Maxim-1301/Projektarbeit_Joystick/KiCAD_Schaltplan/KommModul_Joystick/report.txt

Plot in "C:\Users\jonat\OneDrive\Documents\GitHub\Projektarbeit_Joystick\KiCAD_Schaltplan\KommModul_Joystick\Gerber_Files\KommModul_Joystick-F_Cu.gbr" geschrieben.
Plot in "C:\Users\jonat\OneDrive\Documents\GitHub\Projektarbeit_Joystick\KiCAD_Schaltplan\KommModul_Joystick\Gerber_Files\KommModul_Joystick-B_Cu.gbr" geschrieben.
Plot in "C:\Users\jonat\OneDrive\Documents\GitHub\Projektarbeit_Joystick\KiCAD_Schaltplan\KommModul_Joystick\Gerber_Files\KommModul_Joystick-F_Paste.gbr" geschrieben.
Plot in "C:\Users\jonat\OneDrive\Documents\GitHub\Projektarbeit_Joystick\KiCAD_Schaltplan\KommModul_Joystick\Gerber_Files\KommModul_Joystick-B_Paste.gbr" geschrieben.
Plot in "C:\Users\jonat\OneDrive\Documents\GitHub\Projektarbeit_Joystick\KiCAD_Schaltplan\KommModul_Joystick\Gerber_Files\KommModul_Joystick-F_Silkscreen.gbr" geschrieben.
Plot in "C:\Users\jonat\OneDrive\Documents\GitHub\Projektarbeit_Joystick\KiCAD_Schaltplan\KommModul_Joystick\Gerber_Files\KommModul_Joystick-B_Silkscreen.gbr" geschrieben.
Plot in "C:\Users\jonat\OneDrive\Documents\GitHub\Projektarbeit_Joystick\KiCAD_Schaltplan\KommModul_Joystick\Gerber_Files\KommModul_Joystick-F_Mask.gbr" geschrieben.
Plot in "C:\Users\jonat\OneDrive\Documents\GitHub\Projektarbeit_Joystick\KiCAD_Schaltplan\KommModul_Joystick\Gerber_Files\KommModul_Joystick-B_Mask.gbr" geschrieben.
Plot in "C:\Users\jonat\OneDrive\Documents\GitHub\Projektarbeit_Joystick\KiCAD_Schaltplan\KommModul_Joystick\Gerber_Files\KommModul_Joystick-Edge_Cuts.gbr" geschrieben.
Gerber-Jobdatei "C:\Users\jonat\OneDrive\Documents\GitHub\Projektarbeit_Joystick\KiCAD_Schaltplan\KommModul_Joystick\Gerber_Files\KommModul_Joystick-job.gbrjob" wurde erstellt.
Hinweis: Fertig.
