Maxim-1301/Projektarbeit_Joystick/Auswertung/Hebel_Links_Vor.log.txt

=~=~=~=~=~=~=~=~=~=~=~= PuTTY log 2026.06.17 11:59:13 =~=~=~=~=~=~=~=~=~=~=~=
218 503697 ms FRAME: C5 25 01 00 61  OK
503701 ms FRAME: C5 2F 00 00 6A  OK
503727 ms FRAME: C5 25 01 00 61  OK
503731 ms FRAME: C5 30 00 00 75  OK
503757 ms FRAME: C5 25 01 00 61  OK
503761 ms FRAME: C5 31 0B 53 2C  OK
503787 ms FRAME: C5 25 01 00 61  OK
503791 ms FRAME: C5 32 01 57 21  OK
503817 ms FRAME: C5 25 01 00 61  OK
503821 ms FRAME: C5 3A 00 00 7F  OK
503847 ms FRAME: C5 25 01 00 61  OK
503851 ms FRAME: C5 3B 01 6C 13  OK
503877 ms FRAME: C5 25 01 00 61  OK
503881 ms FRAME: C5 3C 00 00 79  OK
503907 ms FRAME: C5 25 01 00 61  OK
503911 ms FRAME: C5 3D 02 71 0B  OK
503938 ms FRAME: C5 25 01 00 61  OK
503941 ms FRAME: C5 3E 00 16 6D  OK
503968 ms FRAME: C5 25 01 00 61  OK
503971 ms FRAME: C5 3F 0B 6B 1A  OK
503998 ms FRAME: C5 25 01 00 61  OK
504001 ms FRAME: C5 4F 69 7F 1C  OK
504028 ms FRAME: C5 25 01 00 61  OK
504031 ms FRAME: C5 50 02 57 40  OK
504058 ms FRAME: C5 25 01 00 61  OK
504061 ms FRAME: C5 51 00 00 14  OK
504088 ms FRAME: C5 25 01 00 61  OK
504091 ms FRAME: C5 52 02 4B 5E  OK
504118 ms FRAME: C5 25 01 00 61  OK
504121 ms FRAME: C5 1D 04 0B 57  OK
504148 ms FRAME: C5 25 01 00 61  OK
504151 ms FRAME: C5 1E 00 63 38  OK
504178 ms FRAME: C5 25 01 00 61  OK
504181 ms FRAME: C5 1F 00 00 5A  OK
504208 ms FRAME: C5 25 01 00 61  OK
504211 ms FRAME: C5 20 00 00 65  OK
504238 ms FRAME: C5 25 01 00 61  OK
504241 ms FRAME: C5 21 00 00 64  OK
504268 ms FRAME: C5 25 01 00 61  OK
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
532914 ms FRAME: C5 25 01 00 61  OK
532917 ms FRAME: C5 32 01 58 2E  OK
532944 ms FRAME: C5 25 01 00 61  OK
532947 ms FRAME: C5 3A 00 00 7F  OK
532974 ms FRAME: C5 25 01 00 61  OK
532977 ms FRAME: C5 3B 01 42 3D  OK
533004 ms FRAME: C5 25 01 00 61  OK
533007 ms FRAME: C5 3C 00 00 79  OK
5
