Maxim-1301/Projektarbeit_Joystick/Auswertung/Hebel_Links_Zurueck.log.txt

=~=~=~=~=~=~=~=~=~=~=~= PuTTY log 2026.06.17 12:02:02 =~=~=~=~=~=~=~=~=~=~=~=
535256 ms FRAME: C5 25 01 00 61  OK
535260 ms FRAME: C5 20 00 00 65  OK
535286 ms FRAME: C5 25 01 00 61  OK
535290 ms FRAME: C5 21 00 00 64  OK
535316 ms FRAME: C5 25 01 00 61  OK
535320 ms FRAME: C5 22 00 00 67  OK
535346 ms FRAME: C5 25 01 00 61  OK
535350 ms FRAME: C5 23 02 77 13  OK
535376 ms FRAME: C5 25 01 00 61  OK
535380 ms FRAME: C5 2672778 ms FRAME: C5 25 01 00 61  OK
672781 ms FRAME: C5 24 02 5A 39  OK
672808 ms FRAME: C5 25 01 00 61  OK
672811 ms FRAME: C5 25 02 5C 3E  OK
672838 ms FRAME: C5 25 01 00 61  OK
672841 ms FRAME: C5 26 00 02 61  OK
672868 ms FRAME: C5 25 01 00 61  OK
672871 ms FRAME: C5 27 00 0D 6F  OK
672898 ms FRAME: C5 25 01 00 61  OK
672901 ms FRAME: C5 28 63 26 28  OK
672928 ms FRAME: C5 25 01 00 61  OK
672931 ms FRAME: C5 29 1C 04 74  OK
672958 ms FRAME: C5 25 01 00 61  OK
672961 ms FRAME: C5 2A 2B 5E 1A  OK
672988 ms FRAME: C5 25 01 00 61  OK
672991 ms FRAME: C5 2B 0E 0C 6C  OK
673018 ms FRAME: C5 25 01 00 61  OK
673021 ms FRAME: C5 2C 00 00 69  OK
673048 ms FRAME: C5 25 01 00 61  OK
673052 ms FRAME: C5 2D 00 00 68  OK
673078 ms FRAME: C5 25 01 00 61  OK
673082 ms FRAME: C5 2E 00 00 6B  OK
673108 ms FRAME: C5 25 01 00 61  OK
673112 ms FRAME: C5 2F 00 00 6A  OK
673138 ms FRAME: C5 25 01 00 61  OK
673142 ms FRAME: C5 30 00 00 75  OK
673168 ms FRAME: C5 25 01 00 61  OK
673172 ms FRAME: C5 31 0B 53 2C  OK
673198 ms FRAME: C5 25 01 00 61  OK
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
727061 ms FRAME: C5 25 01 00 61  OK
727064 ms FRAME: C5 3B 01 24 5B  OK
727091 ms FRAME: C5 25 01 00 61  OK
727094 ms FRAME: C5 3C 00 00 79  OK
727121 ms FRAME: C5 25 01 00 61  OK
727124 ms FRAME: C5 3D 02 6E 14  OK
727151 ms FRAME: C5 25 01 00 61  OK
727154 ms FRAME: C5 3E 00 13 68  OK
7
