Maxim-1301/Projektarbeit_Joystick/Dokumentation/Projektarbeit_Orange_Blue_Joystick_ma871cas_jo871sto.docx

# Projektarbeit Orange Blue-Motorsteuerung mit Joystick

Student: Castor Maxim

Matrikel Nr.: 310314

Studiengang: EIB 6

Student: Jonathan Stoll

Matrikel Nr.: 310269

Studiengang: EIB6

Hochschulbetreuer/in: Prof. Dr. Boris Boeck

Datum der Abgabe: 28.08.2026

# Abbildungsverzeichnis

# Tabellenverzeichnis

# 1 Einleitung

Das Orange-Blue Projekt ist ein Hochschulprojekt, in dem Studierende, Professoren und Laboringenieure gemeinsam an der Weiterentwicklung eines Tragflügelbootes arbeiten. Ziel des Projekts ist es, verschiedene technische Komponenten des Bootes weiterzuentwickeln und für den praktischen Einsatz zuverlässig nutzbar zu machen.

Ein wichtiger Bestandteil des Systems ist die Steuerung der Antriebsmotoren. Hierfür wird ein Kommunikationsmodul benötigt, das die Eingaben des Fahrers erfasst und in entsprechende Steuerbefehle für die Motoren umsetzt. Das ursprünglich verwendete Bedienmodul des Motorherstellers war für den vorgesehenen Einsatz zuverlässig nutzbar. Mit diesem Steuerungsmodul jedoch werden beide Motoren über separate Hebel angesteuert, was die Nutzung weniger Intuitiv machte.

Aus diesem Grund wurde bereits in einer früheren Bachelorarbeit ein eigenes Kommunikationsmodul für das Tragflügelboot entwickelt, um die Steuerung des Tragflügelbootes einfacher und intuitiver zu gestalten. Über einen Joystick sollte der Fahrer die Fahrtrichtung und die Leistung der Antriebsmotoren direkt vorgeben können. Dadurch sollte eine übersichtliche und einfach zu bedienende Alternative zum ursprünglichen Bedienmodul des Herstellers entstehen.

Bei der Inbetriebnahme des Moduls zeigte sich jedoch, dass das vorhandene Kommunikationsmodul nicht zuverlässig funktionierte und sowohl die Hardware als auch die Software nicht mehr dem aktuellen technischen Stand entsprachen. Daher bestand die Aufgabe darin, das bestehende System zunächst zu analysieren und anschließend gezielt zu überarbeiten.

Ziel der Projektarbeit war es, ein funktionsfähiges und technisch aktualisiertes Kommunikationsmodul aufzubauen. Der Schwerpunkt lag dabei auf der Entwicklung einer neuen Platine, der Überarbeitung der zugehörigen Software und der zuverlässigen Kommunikation mit den Steuerungsplatinen der beiden Motoren. Das grundlegende Funktionsprinzip des bisherigen Systems wurde dabei übernommen und an die neuen Anforderungen angepasst.

# 2 Analyse und Vorgehen

## 2.1 Ausgangssystem und Funktionsweise

Als Grundlage der Projektarbeit diente das Kommunikationsmodul, das im Rahmen einer früheren Bachelorarbeit für das Tragflügelboot entwickelt wurde. Ziel dieses Moduls war es, die Bedienung des Bootes gegenüber dem ursprünglichen Steuergerät des Motorherstellers zu vereinfachen. Der Fahrer sollte das Boot über einen Joystick steuern können, dessen Auslenkung in entsprechende Fahr- und Leistungsbefehle für die Antriebsmotoren umgesetzt wird. Zusätzlich sollten wichtige Betriebs- und Statusinformationen der Motoren auf einem Display dargestellt werden.

Die zentrale Verarbeitung des alten Moduls übernimmt ein ATmega1284P-Mikrocontroller. Dieser wertet die drei Achsen des Joysticks sowie dessen Taster aus und erzeugt daraus die Steuerbefehle für die Motoren. Für die Kommunikation mit den Motorsteuerungen sind zwei getrennte RS485-Schnittstellen vorgesehen. Die dafür benötigten UART-Signale des Mikrocontrollers werden über MAX485-Transceiver auf den RS485-Bus umgesetzt. Der Anschluss der beiden Motoren erfolgt über jeweils eine eigene Verbindung.

Das Kommunikationsmodul arbeitet gegenüber den Motorsteuerungen als Master. Es sendet Steuerbefehle an die Motoren und empfängt anschließend deren Antworten. Die Kommunikation erfolgt zyklisch und basiert auf dem vom Motorhersteller vorgegebenen Protokoll. Neben den eigentlichen Fahrbefehlen können dadurch auch Betriebsdaten der Motoren empfangen und ausgewertet werden.

Die Eingaben des Joysticks werden über integrierte Hallsensoren erfasst. Je nach Auslenkung der einzelnen Achsen verändert sich die ausgegebene analoge Spannung. Diese Spannungswerte werden vom Mikrocontroller über seine ADC-Eingänge eingelesen und anschließend in Fahrtrichtung und Leistungsanforderung für die Motoren umgerechnet. In der Mittelstellung liegt die Ausgangsspannung ungefähr bei 2,3 V, während sie sich je nach Auslenkung in Richtung 0 V beziehungsweise bis etwa 4,6 V verändert. Die vom Motor zurückgesendeten Statusinformationen werden anschließend verarbeitet und auf einem 4×20-Zeichen-Display ausgegeben. Das Display wird über eine I²C-Schnittstelle und einen Portexpander angesteuert.

Das ursprüngliche Konzept war außerdem so ausgelegt, dass das System auf vier Motoren erweitert werden konnte. Dafür war eine zweite Platine vorgesehen, die über eine SPI-Verbindung mit der Hauptplatine kommuniziert. Für die in dieser Projektarbeit betrachtete Überarbeitung stand jedoch zunächst die zuverlässige Ansteuerung der beiden vorhandenen Motoren im Vordergrund.

Da Aufbau und Funktionsweise des ursprünglichen Kommunikationsmoduls bereits ausführlich in der Bachelorarbeit dokumentiert sind, werden sie an dieser Stelle nur in dem für die weitere Bearbeitung notwendigen Umfang betrachtet. Der Schwerpunkt der folgenden Kapitel liegt auf der Analyse der vorhandenen Lösung sowie der daraus abgeleiteten Überarbeitung von Hard- und Software

## 2.2 Analyse der Hardware und Software

### 2.2.1 Hardware

Für die Analyse der vorhandenen Hardware wurden die Bachelorarbeit, die bereits gefertigte Platine sowie das zugehörige KiCad-Projekt herangezogen. Ziel war es, den Aufbau des bestehenden Kommunikationsmoduls nachzuvollziehen und mögliche Ursachen für die eingeschränkte Funktion zu finden.

Dazu wurden die einzelnen Komponenten der Schaltung schrittweise untersucht. Betrachtet wurden unter anderem die Spannungsversorgung, die Beschaltung des Mikrocontrollers, die RS485-Schnittstellen, die Joystickanbindung sowie die Displaysteuerung. Zusätzlich wurde die gefertigte Platine mit einem Multimeter auf Durchgang geprüft. Dadurch sollten mögliche Kurzschlüsse, unterbrochene Verbindungen oder Fehler im Leiterplattenrouting erkannt werden. Der grundsätzliche Aufbau entsprach dabei dem in der Bachelorarbeit beschriebenen Konzept.

Bei der Untersuchung konnten keine eindeutigen hardwareseitigen Fehler festgestellt werden, die das fehlerhafte Verhalten des Kommunikationsmoduls erklären konnten. Einzelne Dimensionierungen waren jedoch nicht vollständig nachvollziehbar. Dazu gehörte beispielsweise die Verwendung eines vergleichsweise großen Pufferkondensators von 330 µF. Da sich daraus jedoch kein direkter Funktionsfehler ableiten ließ, wurde die bestehende Hardware grundsätzlich als funktionsfähig bewertet.

Aus diesem Grund wurde entschieden, den grundlegenden Aufbau des vorhandenen Kommunikationsmoduls als Basis für die neue Hardware zu verwenden. Das betraf vor allem die Aufteilung in Mikrocontroller, Joystickanbindung, zwei RS485-Schnittstellen und Displayansteuerung. Für die neue Umsetzung waren dennoch mehrere Anpassungen notwendig, insbesondere durch den Wechsel auf einen STM32-Mikrocontroller und die damit verbundenen elektrischen Anforderungen. Diese Änderungen werden im Kapitel zur Hardwareentwicklung näher beschrieben.

### 2.2.2 Software

Für die Analyse der vorhandenen Software wurden die einzelnen C-Dateien sowie die zugehörigen Header-Dateien des Projekts untersucht. Ziel war es zunächst, den Aufbau des Programms und das Zusammenspiel der einzelnen Softwaremodule nachzuvollziehen. Dabei wurden vor allem die Verarbeitung der Joystickwerte, die Kommunikation mit den Motorsteuerungen sowie die Ansteuerung der verwendeten Peripherie betrachtet. Die ursprüngliche Software war bereits in mehrere Teilprogramme gegliedert, unter anderem für UART, ADC, I²C und die Verarbeitung der Motordaten.

Bei der Durchsicht des Programmcodes fielen mehrere kleinere Stellen auf, die nicht eindeutig oder nicht sauber umgesetzt waren. Zwei Punkte wurden dabei als besonders relevant für die eingeschränkte Funktion des Kommunikationsmoduls eingestuft.

Der erste Punkt betraf die UART-Kommunikation mit den Motorsteuerungen. Die vorhandene Implementierung entsprach teilweise nicht dem im Datenblatt des ATmega beschriebenen Ablauf für das Senden und Empfangen von Daten. Insbesondere die Abfrage und Verarbeitung empfangener Daten war nicht eindeutig umgesetzt. Dadurch konnte nicht ausgeschlossen werden, dass einzelne Bytes fehlerhaft oder zum falschen Zeitpunkt verarbeitet wurden. Dies stellte eine mögliche Ursache für eine unzuverlässige Kommunikation mit den Motorsteuerungen dar.

Der zweite und deutlich schwerwiegendere Punkt wurde bei der Verarbeitung der Joystickwerte festgestellt. Der aus der Joystickauslenkung berechnete Leistungswert wurde in der vorhandenen Software lediglich auf einen Maximalwert von 0x07 begrenzt. Dieser Wert wird anschließend innerhalb des Beschleunigungskommandos an die Motorsteuerung übertragen. Warum der Wertebereich auf 0x00 bis 0x07 festgelegt worden war, konnte aus der vorhandenen Dokumentation und dem Programmcode nicht eindeutig nachvollzogen werden. Möglicherweise wurde der Wert zu Testzwecken auf den geringen Leistungswert maximiert, jedoch wurde diesbezüglich nichts in der Bachelorarbeit dokumentiert.

Diese Auffälligkeit passte zu den Erfahrungen aus früheren Tests des bestehenden Kommunikationsmoduls. Dabei konnten die Motoren grundsätzlich angesteuert werden, erreichten jedoch nur eine sehr geringe Drehzahl. Es bestand daher der Verdacht, dass der in der Software verwendete Wertebereich nicht dem tatsächlich von der Motorsteuerung erwarteten Leistungsbereich entsprach.

Um diesen Verdacht zu überprüfen und den tatsächlichen Aufbau der Kommunikation genauer zu untersuchen, wurde anschließend die Kommunikation des originalen Bedienmoduls des Herstellers mitgeschnitten und ausgewertet. Dadurch konnte der tatsächlich verwendete Wertebereich der Motoransteuerung bestimmt und die zuvor festgestellte Auffälligkeit in der Software überprüft werden.

## 2.3 Untersuchung der Motorkommunikation

Um den tatsächlichen Aufbau der Kommunikation zwischen dem originalen Bedienmodul des Herstellers und den Motorsteuerungen zu überprüfen, wurde die RS485-Kommunikation während des Betriebs mitgeschnitten. Dazu wurde ein separates Testmodul verwendet, das über einen RS485-Transceiver parallel an die Kommunikationsleitung zwischen Bedienmodul und Motor angeschlossen wurde. Dadurch konnten die übertragenen Daten mitgelesen werden, ohne die bestehende Kommunikation zu beeinflussen.

Das originale Bedienmodul kann sowohl über die kabelgebundene Verbindung als auch über Funk mit den Motoren kommunizieren. Für die Untersuchung wurde gezielt die kabelgebundene Kommunikation ausgewertet, da das neue Kommunikationsmodul mit dem Joystick ebenfalls über ein RS485 Kabel mit den Motoren verbunden werden sollte. Während der Messungen wurden die Fahrhebel in verschiedene Positionen bewegt und die dabei übertragenen Daten aufgezeichnet. Ziel war es, den tatsächlichen Aufbau der Steuerbefehle und insbesondere die Übertragung von Fahrtrichtung und Leistungswert zu bestimmen.

Die Kommunikation zwischen Bedienmodul und Motorsteuerung erfolgt in Form von fünf Byte langen Datenframes. Jedes Frame beginnt mit dem Adressbyte 0xC5. Darauf folgt ein Kommando- beziehungsweise Statusbyte, das festlegt, welche Information übertragen wird. Die beiden nachfolgenden Datenbytes enthalten die eigentlichen Nutzdaten. Das letzte Byte bildet die Checksumme zur Überprüfung des Frames. Dieser grundsätzliche Aufbau entspricht auch der Beschreibung in der bestehenden Bachelorarbeit.

Für die Untersuchung der Motoransteuerung war insbesondere das Beschleunigungskommando 0x25 relevant. In dem zugehörigen Datenframe enthält das dritte Byte die Information über die Fahrtrichtung, während das vierte Byte den angeforderten Leistungswert überträgt. Bei Vorwärtsfahrt wird im dritten Byte der Wert 0x01, bei Rückwärtsfahrt der Wert 0x00 gesendet. Der Wert im vierten Byte verändert sich abhängig von der Stellung des Fahrhebels und gibt damit die gewünschte Motorleistung vor.

Da RS485 in diesem System als Halbduplex-Verbindung betrieben wird, kann zu einem Zeitpunkt jeweils nur ein Teilnehmer senden. Nach dem Senden eines Kommando-Frames schaltet das Bedienmodul daher vom Sende- in den Empfangsbetrieb um. Die Motorsteuerung antwortet anschließend mit einem eigenen fünf Byte langen Frame. Danach wird wieder in den Sendebetrieb gewechselt und das nächste Kommando übertragen. Im aufgezeichneten Verlauf ist dieses Wechselspiel deutlich zu erkennen.

Der Aufbau eines aufgezeichneten Frames kann damit vereinfacht wie folgt dargestellt werden:

Byte | Bedeutung
1 | Adresse 0xC5
2 | Kommando
3 | Fahrtrichtung
4 | Leistungswert
5 | Checksumme

Tabelle 1, Aufbau Datenframes

Die Abbildung1 zeigt einen Ausschnitt des mit PuTTY aufgezeichneten Kommunikationsverlaufs während einer zunehmenden Vorwärtsauslenkung des Fahrhebels.

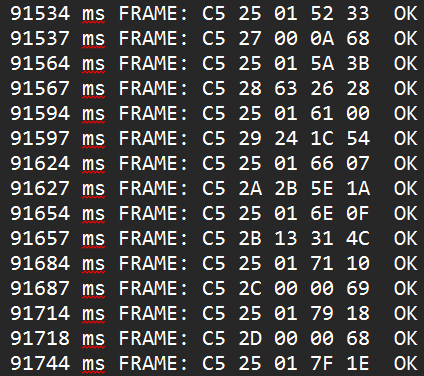
[picture p1: figure]

Abbildung 1, Mitschnitt Kommunikation

Die vom Bedienmodul gesendeten Beschleunigungsframes beginnen jeweils mit C5 25. Das erste Byte 0xC5 ist die Adresse der Motorsteuerung, während das zweite Byte 0x25 das Beschleunigungskommando kennzeichnet. Im dritten Byte wird die Fahrtrichtung übertragen. Im dargestellten Ausschnitt bleibt dieser Wert durchgehend auf 0x01, was der Vorwärtsfahrt entspricht. Das vierte Byte enthält den Leistungswert und verändert sich mit der Stellung des Fahrhebels.

Im Log ist zu erkennen, dass dieser Leistungswert mit zunehmender Auslenkung schrittweise ansteigt. Er verändert sich im dargestellten Abschnitt beispielsweise von 0x52 über 0x5A, 0x61, 0x66, 0x6E, 0x71 und 0x77 bis zum Maximalwert 0x7F.

Das letzte Frame des Ausschnitts C5 25 01 7F 1E entspricht damit einer vollständigen Vorwärtsauslenkung des Fahrhebels. Der Wert 0x7F im vierten Byte stellt die maximale Leistungsanforderung dar. In Neutralstellung wurde dagegen der Leistungswert 0x00 übertragen.

Zwischen den Beschleunigungsframes sind die Antworten der Motorsteuerung zu erkennen. Nach dem Senden eines 0x25-Frames wird die RS485-Schnittstelle vom Sende- in den Empfangsbetrieb umgeschaltet. Die Motorsteuerung antwortet daraufhin mit einem eigenen Frame, bevor das Bedienmodul wieder das nächste Beschleunigungskommando sendet. Im dargestellten Ausschnitt sind dabei verschiedene Statusantworten mit Kennungen wie 0x27, 0x28, 0x29 oder 0x2D zu erkennen. Die Bedeutung dieser Antwortkennungen ist ebenfalls in der Bachelorarbeit dokumentiert. In dieser Tabelle sind jedoch nicht alle Kommandos festgehalten. Im Laufe der Projektarbeit haben wir bei dem Hersteller der Motoren ePropulsion eine vollständige Tabelle dieser Kommandos angefragt aber leider nie eine Antwort erhalten.

Durch die Messung konnte, der zuvor bei der Softwareanalyse vermutete Fehler eindeutig bestätigt werden. In der vorhandenen Software des Kommunikationsmoduls wurde der aus der Joystickauslenkung berechnete Leistungswert lediglich auf einen Maximalwert von 0x07 begrenzt. Das originale Bedienmodul verwendet dagegen einen Wertebereich bis 0x7F.

Damit erklärt sich auch das Verhalten bei früheren Tests des bestehenden Kommunikationsmoduls. Die Motoren reagierten zwar auf die übertragenen Steuerbefehle, erreichten jedoch nur eine sehr geringe Drehzahl. Ursache dafür war, dass mit dem Maximalwert 0x07 nur ein kleiner Teil des tatsächlich vorgesehenen Leistungsbereichs genutzt wurde.

Die Auswertung des aufgezeichneten Kommunikationsverlaufs bestätigte somit sowohl den Aufbau des Beschleunigungskommandos als auch den korrekten Wertebereich der Motoransteuerung. Diese Ergebnisse wurden anschließend als Grundlage für die Überarbeitung der Software verwendet.

## 2.4 Schlussfolgerung für anstehende Überarbeitung

Die Analyse des bestehenden Kommunikationsmoduls zeigte, dass der grundlegende Aufbau des Systems weiterhin als geeignete Grundlage für eine Überarbeitung verwendet werden konnte. Bei der Untersuchung der Hardware konnten keine eindeutigen Fehler festgestellt werden, die die eingeschränkte Funktion des Moduls erklärten. Aus diesem Grund wurde das bestehende Hardwarekonzept grundsätzlich beibehalten und als Ausgangspunkt für die neue Platine verwendet.

Deutlich größere Probleme zeigten sich bei der vorhandenen Software. Neben einer nicht sauber umgesetzten UART-Kommunikation wurde insbesondere die fehlerhafte Skalierung des an die Motorsteuerung übertragenen Leistungswertes festgestellt. Durch das Mitschneiden der Kommunikation des originalen Bedienmoduls konnte verifiziert werden, dass der maximale Leistungswert 0x7F beträgt und nicht, wie in der bestehenden Software umgesetzt, 0x07. Damit konnte eine wesentliche Ursache für die sehr geringe Motordrehzahl bei früheren Tests des bestehenden Moduls identifiziert werden.

Aus den Ergebnissen der Analyse ergaben sich damit zwei zentrale Aufgaben für die weitere Bearbeitung. Zum einen musste die Hardware an einen aktuellen Mikrocontroller und dessen elektrische Anforderungen angepasst werden. Zum anderen war eine Überarbeitung der Software notwendig, insbesondere im Bereich der Motoransteuerung und der UART-/RS485-Kommunikation.

Die folgenden Kapitel beschreiben daher getrennt die Überarbeitung der Hardware und die Entwicklung der neuen Software. Dabei wird erläutert, welche Bestandteile des bestehenden Systems übernommen wurden, welche Änderungen notwendig waren und wie die zuvor identifizierten Probleme in der neuen Umsetzung berücksichtigt wurden.

# 3 Hardware

## 3.1 Hardwareübersicht

Die Hardware des überarbeiteten Kommunikationsmoduls wurde in mehrere Funktionsbereiche unterteilt. Im Mittelpunkt steht der Mikrocontroller STM32F303, der die Eingangssignale des Joysticks verarbeitet, die Kommunikation mit den Motorsteuerungen übernimmt und die weiteren Peripheriekomponenten ansteuert. Der STM32 wurde gewählt, da er die benötigten Schnittstellen, wie UART oder I^2c, und ADC-Kanäle bereitstellt und gleichzeitig eine aktuelle sowie gut unterstützte Mikrocontrollerplattform für die weitere Entwicklung bietet. Ein Großteil der für die Umsetzung benötigten Standardbauteile und Steckverbinder wurde von Würth Elektronik zur Verfügung gestellt. Daher wurden, soweit technisch sinnvoll, Komponenten aus diesem Sortiment verwendet.

Ergänzt wird der Mikrocontroller durch die Spannungsversorgung, zwei getrennte RS485-Schnittstellen, die Joystickanbindung, die Displayansteuerung sowie die Programmier- und Testschnittstellen. Abbildung 2 zeigt den grundlegenden Aufbau der Hardware und die Verbindung der einzelnen Funktionsblöcke. Die Aufteilung orientiert sich am bestehenden Konzept des ursprünglichen Kommunikationsmoduls, wurde jedoch an die Anforderungen der neuen Mikrocontrollerplattform und der überarbeiteten Schaltung angepasst.

In den folgenden Abschnitten werden die einzelnen Funktionsbereiche näher beschrieben. Der Schwerpunkt liegt dabei auf den vorgenommenen Änderungen, deren technischer Begründung und der jeweiligen Umsetzung im Schaltplan.

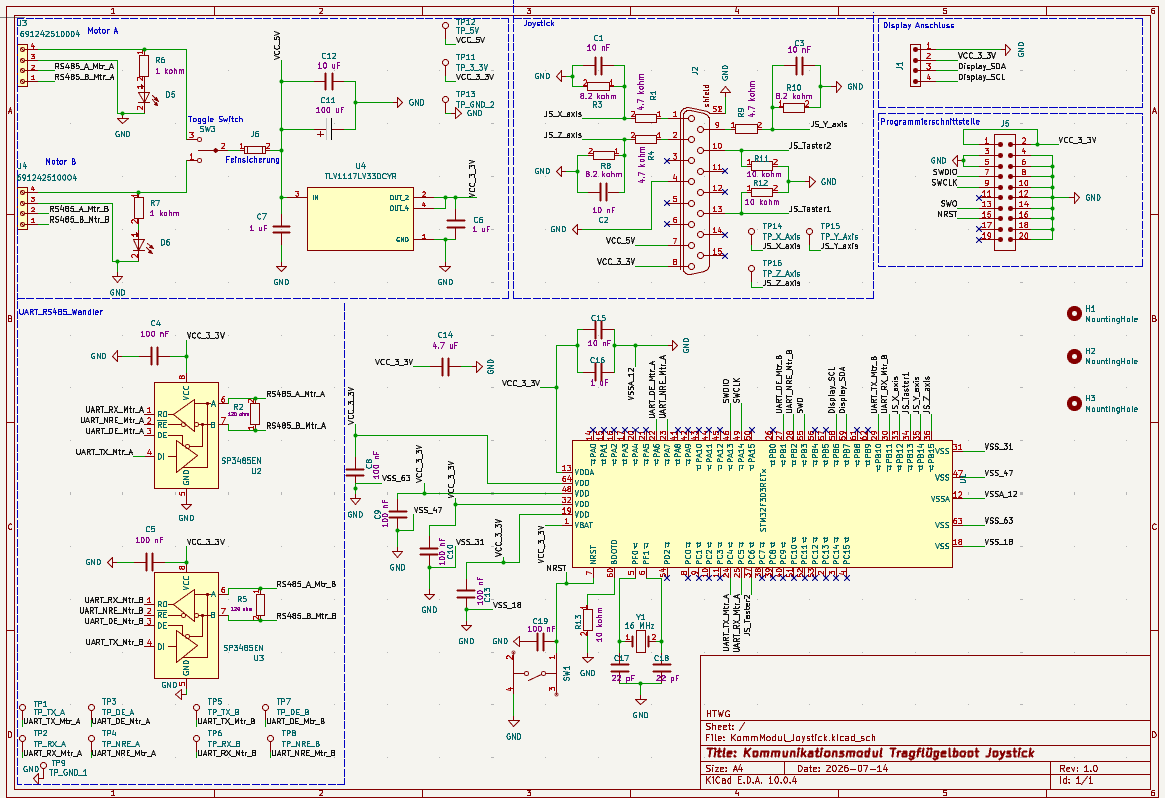
[picture p2: figure]

Abbildung 2, Aufbau Hardware

## 3.2 Beschaltung Microcontroller

Als zentrale Recheneinheit des überarbeiteten Kommunikationsmoduls wurde ein STM32F303RE eingesetzt. Für diese Wahl sprachen mehrere Gründe. Zum einen waren bereits Erfahrungen mit der STM32-Plattform und der zugehörigen Entwicklungsumgebung vorhanden. Zum anderen stellt der Mikrocontroller alle für das Projekt benötigten Schnittstellen zur Verfügung. Dazu gehören mehrere UART-Schnittstellen für die Kommunikation mit den Motorsteuerungen, ADC-Eingänge für die Auswertung des Joysticks, eine I²C-Schnittstelle für das Display sowie verschiedene GPIO-Pins für Steuer- und Statussignale. Zusätzlich kann der Mikrocontroller über die SWD-Schnittstelle programmiert und debuggt werden.

Eine weitere Anforderung an die Überarbeitung war die Umstellung des Systems auf eine Logikspannung von 3,3 V. Der STM32F303RE ist für den Betrieb mit dieser Versorgungsspannung geeignet und passte damit ebenfalls gut zu dem neuen Hardwarekonzept. Durch den Wechsel von der bisherigen 5-V-Plattform auf 3,3 V mussten jedoch mehrere angeschlossene Schaltungsteile angepasst werden. Diese Änderungen werden in den folgenden Abschnitten näher beschrieben.

Die Grundbeschaltung des Mikrocontrollers wurde anhand des Datenblatts und der technischen Dokumentation von STMicroelectronics ausgelegt.

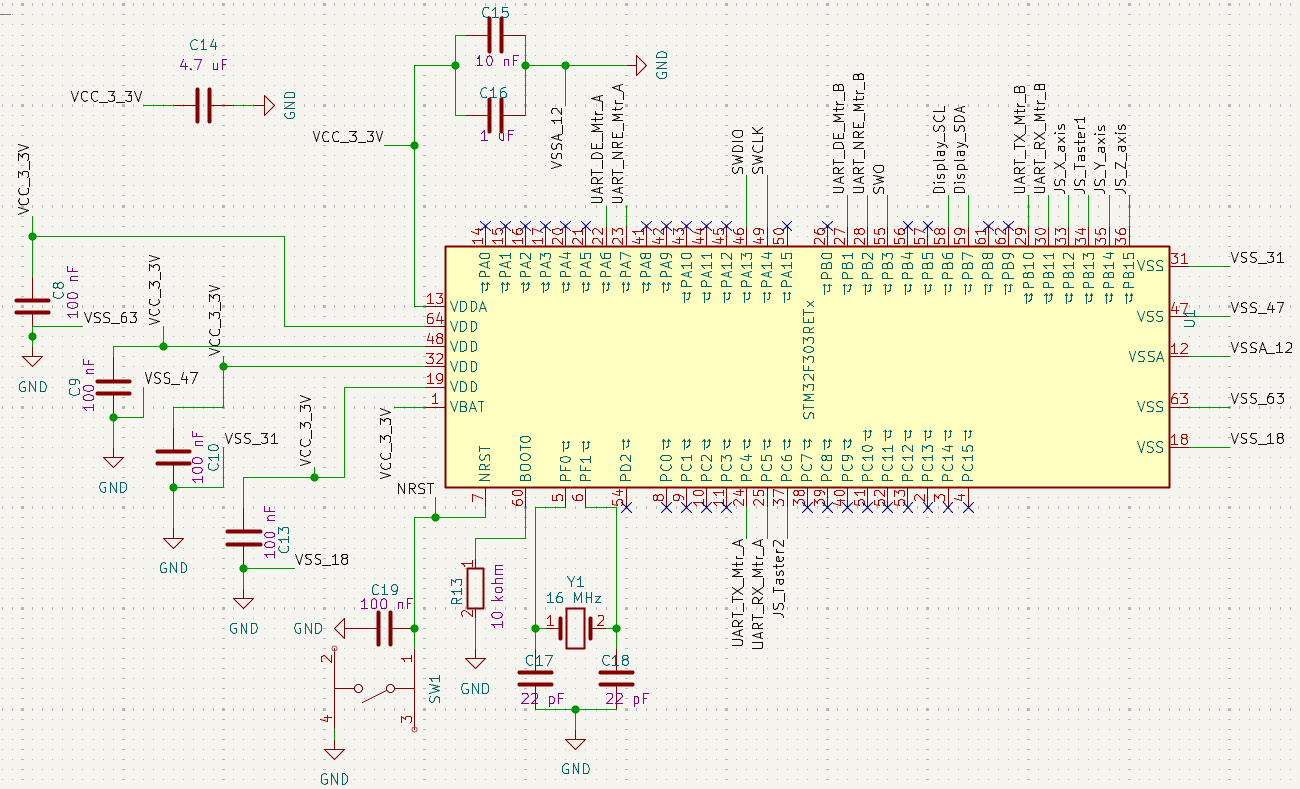
[picture p3: figure]

Abbildung 3, Beschaltung des Microcontrollers

Abbildung 3 zeigt den entsprechenden Schaltplanausschnitt. Die digitalen Versorgungspins VDD werden mit 3,3 V versorgt. Zur lokalen Entkopplung sind an den Versorgungspins jeweils 100-nF-Kondensatoren gegen Masse vorgesehen. Zusätzlich befindet sich mit C14 ein 4,7-µF-Kondensator an der 3,3-V-Versorgung, der als zusätzlicher Puffer dient. Sämtliche VSS-Pins des Mikrocontrollers sind mit Masse verbunden.

Auch die analoge Versorgung des Mikrocontrollers wurde separat berücksichtigt. Der VDDA-Pin wird ebenfalls mit 3,3 V versorgt und über C15 mit 10 nF sowie C16 mit 1 µF gegen Masse entkoppelt. Der zugehörige VSSA-Pin ist mit Masse verbunden. Diese Beschaltung ist insbesondere für die Nutzung der ADC-Eingänge relevant, da über diese später die analogen Ausgangssignale des Joysticks eingelesen werden. Die Dimensionierung und Anordnung der Entkopplungskondensatoren orientierten sich dabei an den Vorgaben des Herstellers.

Für die Takterzeugung wurde ein externer 16-MHz-Quarz vorgesehen. Dieser ist über die entsprechenden Oszillatorpins des Mikrocontrollers angeschlossen. Die beiden Lastkondensatoren C17 und C18 mit jeweils 22 pF ergänzen die Quarzbeschaltung. Der externe Takt dient als stabile Grundlage für den späteren Systemtakt des Mikrocontrollers und damit auch für die zeitkritische Kommunikation mit den Motorsteuerungen.

Der BOOT0-Pin wird über den Widerstand R13 mit 10 kΩ auf Masse gezogen. Dadurch liegt im normalen Betrieb ein definierter Low-Pegel an und der Mikrocontroller startet nach einem Reset aus dem internen Flash-Speicher. Ein unbeabsichtigtes Starten in einen anderen Boot-Modus wird damit verhindert.

Für einen manuellen Hardware-Reset ist der NRST-Pin über den Taster SW1 mit Masse verbunden. Zusätzlich ist C19 mit 100 nF an der Reset-Leitung vorgesehen. Durch Betätigen des Tasters wird der NRST-Pin auf Low gezogen und der Mikrocontroller in einen definierten Ausgangszustand zurückgesetzt.

Im Schaltplan sind außerdem die für UART, I²C, ADC, SWD und die weiteren GPIO-Funktionen verwendeten Pins des Mikrocontrollers dargestellt. Die genaue Zuordnung dieser Pins zu den jeweiligen Softwarefunktionen wird im Softwarekapitel nochmals anhand der Mikrocontrollerkonfiguration zusammengefasst.

## 3.3 Spannungsversorgung

Die Spannungsversorgung des Kommunikationsmoduls erfolgt direkt über die beiden Motoranschlüsse J3 und J4. Über diese Verbindungen werden neben den RS485-Signalen auch 5 V und GND vom jeweiligen Motor zur Platine geführt. Die Pins für RS485-A und RS485-B werden dabei direkt zu den zugehörigen RS485-Transceivern weitergeführt, während die 5-V-Leitung für die Versorgung des Kommunikationsmoduls genutzt wird. Damit ist keine zusätzliche externe Spannungsquelle für die Platine erforderlich.

Da beide Motoranschlüsse eine Versorgung bereitstellen, kann über den Wahlschalter SW3 ausgewählt werden, von welchem Motor die Platine gespeist wird. Die LEDs D5 und D6 zeigen an, ob am jeweiligen Anschluss eine Versorgungsspannung anliegt. Dadurch kann bereits bei der Inbetriebnahme schnell überprüft werden, ob eine Spannung an beiden Eingängen anliegt.

Hinter dem Wahlschalter befindet sich eine Feinsicherung mit einem Nennstrom von 600 mA. Sie schützt die Platine und die angeschlossenen Leitungen bei einem Kurzschluss oder einer ungewöhnlich hohen Stromaufnahme. Die maximale Stromaufnahme des Kommunikationsmoduls wurde aus den verwendeten Komponenten abgeschätzt und liegt im normalen Betrieb deutlich unter 300 mA. Der Sicherungswert von 600 mA bietet damit ausreichend Reserve für kurzzeitige Lastspitzen, bleibt aber gleichzeitig niedrig genug, um bei einem Fehler eine wirksame Schutzfunktion zu erfüllen.

Die vom Motor bereitgestellten 5 V werden als Versorgungsschiene VCC_5V auf der Platine weitergeführt. Zur Stabilisierung dieser Spannung sind die Kondensatoren C11 mit 100 µF und C12 mit 10 µF vorgesehen. C11 dient als Puffer für langsamere oder kurzzeitige Spannungseinbrüche und Laständerungen. C12 ergänzt die Pufferung bei schnellen auftretenden Störungen. Gegenüber der bestehenden Hardware wurde bewusst auf eine deutlich größere Pufferkapazität verzichtet, da bei der Analyse keine Notwendigkeit für eine so große Kapazität festgestellt werden konnte.

Da der neue Mikrocontroller und ein Großteil der weiteren Logik mit 3,3 V betrieben werden, muss aus den vorhandenen 5 V zusätzlich eine 3,3-V-Versorgung erzeugt werden. Dafür wird der Low-Dropout-Regler TLV1117LV33 verwendet. Der LDO reduziert die Eingangsspannung von 5 V auf eine konstante Ausgangsspannung von 3,3 V. Die Spannungsdifferenz wird dabei im Regler in Wärme umgesetzt. Aufgrund der vergleichsweise geringen Leistungsaufnahme des Kommunikationsmoduls ist diese einfache Form der Spannungswandlung für die Anwendung ausreichend. Außerdem wurde beim Platinen Routing und Layout darauf geachtet, dass eine größere Zone um den LDO gelegt wurde, um die Wärmeabfuhr zu optimieren.

Am Eingang und Ausgang des Spannungsreglers befinden sich mit C7 und C6 jeweils 1-µF-Kondensatoren, die Werte stammten aus dem Datenblatt von Texas Industries. Die beiden Kondensatoren dienen der Stabilisierung des Reglers und unterstützen ein sauberes Ein- und Ausschwingverhalten. Die erzeugten 3,3 V werden anschließend als Versorgungsschiene VCC_3.3V an den Mikrocontroller und die weiteren mit 3,3 V betriebenen Schaltungsteile verteilt.

Für die Inbetriebnahme und spätere Fehlersuche wurden zusätzlich Testpunkte für 5 V, 3,3 V und GND vorgesehen. Dadurch können die Versorgungsspannungen direkt auf der Platine gemessen werden, ohne an Bauteilpins oder Leiterbahnen arbeiten zu müssen. Dies erleichtert sowohl die Erstinbetriebnahme als auch die spätere Diagnose möglicher Fehler.

Abbildung 4 zeigt den vollständigen Aufbau der Spannungsversorgung von den Motoranschlüssen J3 und J4 über Wahlschalter und Feinsicherung bis zur Erzeugung der 3,3-V-Versorgung.

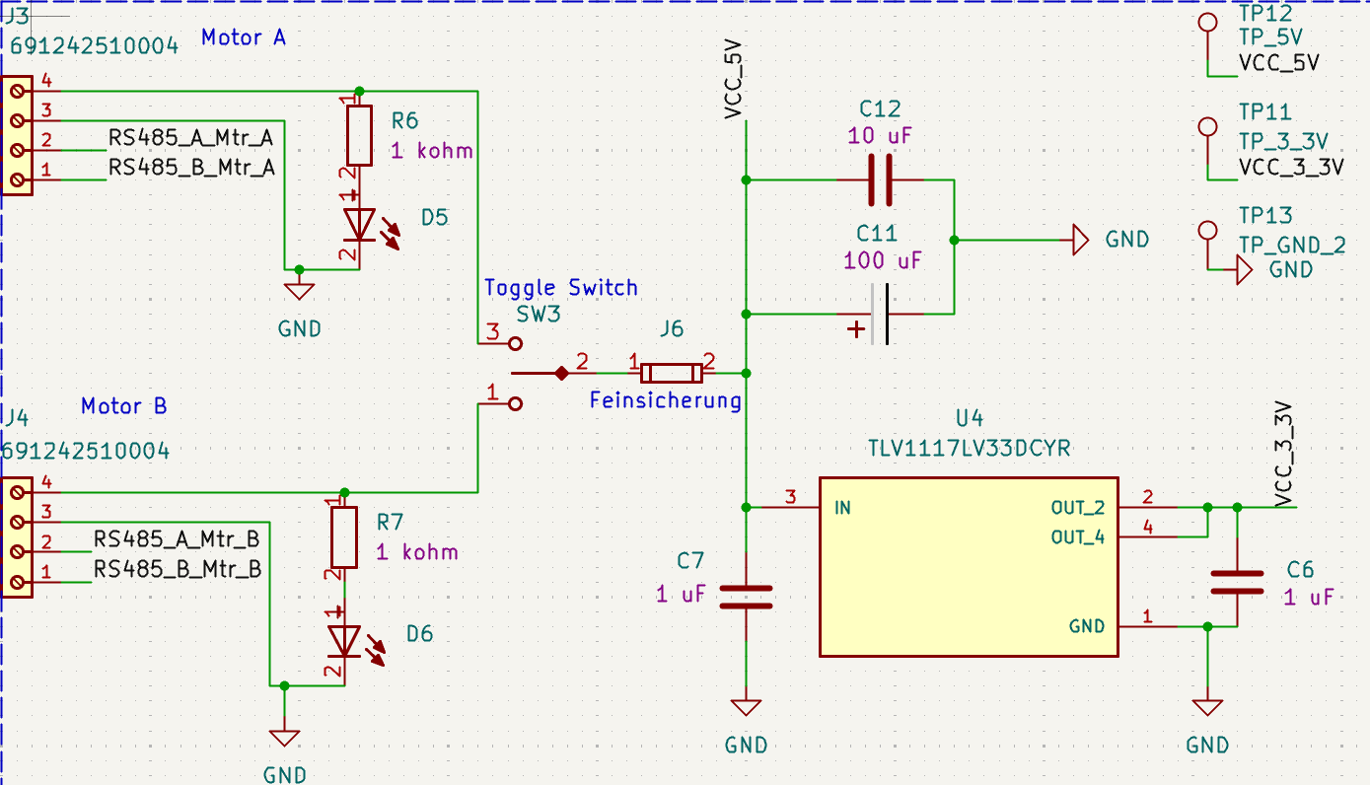
[picture p4: figure]

Abbildung 4, Versorgungsschaltung

## 3.4 RS485-Schnittstelle

Für die Kommunikation mit den beiden Motorsteuerungen werden zwei getrennte UART-/RS485-Schnittstellen verwendet. Der grundsätzliche Aufbau orientiert sich stark an der Lösung aus der bestehenden Bachelorarbeit, da sich dieses Konzept für die Anbindung der beiden Motoren bewährt hat. Die beiden Kommunikationskanäle sind identisch aufgebaut und jeweils einem Motor fest zugeordnet.

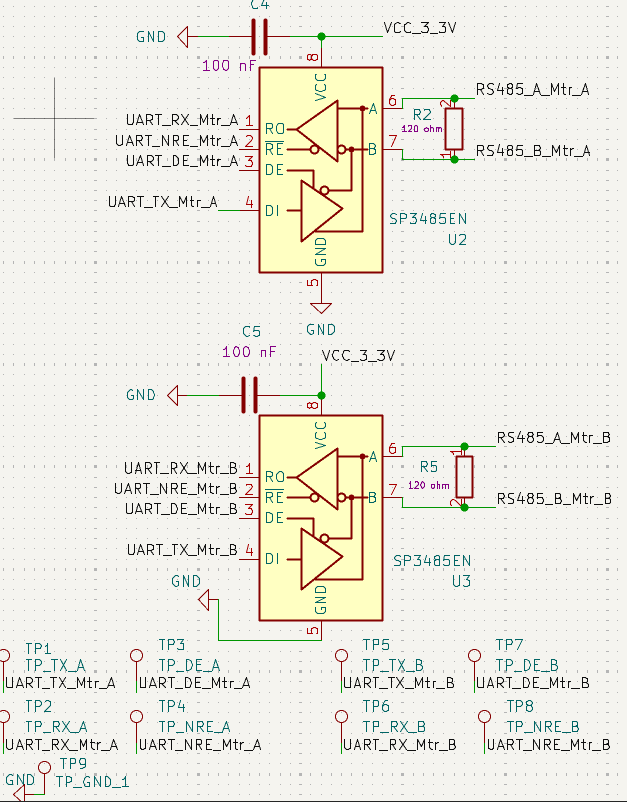
[picture p5: figure]

Abbildung 5, RS485 Schaltung

Im ursprünglichen Kommunikationsmodul wurden MAX485-Transceiver eingesetzt. Diese arbeiten mit einer Versorgungsspannung von 5 V und waren daher für das neue 3,3-V-Konzept nur eingeschränkt geeignet. Aus diesem Grund wurden sie durch SP3485-Transceiver ersetzt. Diese können direkt mit 3,3 V betrieben werden und passen damit besser zur Versorgungsspannung des STM32 und zur restlichen Logik der neuen Platine.

Der STM32 stellt für jeden Motor eine eigene UART-Schnittstelle bereit. Das UART-Signal arbeitet intern mit den üblichen digitalen TX- und RX-Leitungen. Der SP3485 übernimmt anschließend die Umsetzung dieses Signals auf die differentielle RS485-Schnittstelle. Beim Senden wird das TX-Signal des Mikrocontrollers über den Eingang DI des Transceivers auf die beiden Busleitungen A und B umgesetzt. Beim Empfang werden die differentiellen Signale des RS485-Busses über den Ausgang RO wieder als digitales RX-Signal an den Mikrocontroller weitergegeben.

Da die Kommunikation mit den Motorsteuerungen im Halbduplexbetrieb erfolgt, kann jeweils nur eine Seite gleichzeitig senden. Die Umschaltung zwischen Sende- und Empfangsbetrieb erfolgt über die Pins DE und RE des Transceivers. Diese werden separat vom Mikrocontroller angesteuert. Für den Sendebetrieb wird der Treiber aktiviert, während für den Empfang der Empfänger freigegeben wird. Nach dem Senden eines Kommandos wird wieder in den Empfangsbetrieb gewechselt, damit die Antwort der Motorsteuerung eingelesen werden kann.

Die beiden RS485-Schnittstellen sind jeweils mit einem 120-Ω-Abschlusswiderstand zwischen den Leitungen A und B versehen. Dieser dient der Anpassung an die Busleitung und reduziert Reflexionen an den Leitungsenden. Zusätzlich ist an jedem SP3485 ein 100-nF-Kondensator direkt an der Versorgung vorgesehen. Dieser dient zur lokalen Entkopplung der 3,3-V-Versorgung und reduziert kurzzeitige Spannungsschwankungen beim Schalten des Transceivers.

Für beide Kommunikationskanäle wurden außerdem Testpunkte für TX, RX, DE und RE vorgesehen. Dadurch lassen sich sowohl die UART-Signale als auch die Umschaltung zwischen Sende- und Empfangsbetrieb während der Inbetriebnahme direkt messen. Dies erleichtert insbesondere die Fehlersuche bei Kommunikationsproblemen.

Insgesamt wurde damit das bewährte Grundkonzept des ursprünglichen Kommunikationsmoduls übernommen, jedoch an die neue 3,3-V-Hardwareplattform angepasst. Die größte Änderung bestand im Austausch der bisherigen MAX485-Transceiver durch SP3485-Bausteine, wodurch eine direkte und konsistente Anbindung an den STM32 möglich wurde.

## 3.5 Joystick Steuerung

Der vorhandene Joystick wurde auch für das überarbeitete Kommunikationsmodul weiterverwendet. Die Auslenkung der drei Achsen wird über integrierte Hallsensoren erfasst. Diese geben abhängig von der Stellung des Joysticks eine analoge Spannung aus. In der Neutralstellung beträgt diese etwa 2,3 V und verändert sich je nach Auslenkung im Bereich von ungefähr 0 V bis 4,6 V. Die Spannungswerte werden anschließend über die ADC-Eingänge des Mikrocontrollers ausgewertet. Zusätzlich besitzt der Joystick zwei Taster, deren Signale über digitale GPIO-Eingänge eingelesen werden.

Eine wichtige Anpassung gegenüber der ursprünglichen Schaltung war die Begrenzung der analogen Ausgangsspannung des Joysticks. Das bestehende System arbeitete mit einer 5-V-Plattform, während die ADC-Eingänge des neuen STM32 mit 3,3 V betrieben werden. Eine zu hohe Eingangsspannung könnte die zulässigen Pegel des Mikrocontrollers überschreiten und im ungünstigsten Fall zu einer Beschädigung der ADC-Eingänge führen. Aus diesem Grund wurden für alle drei Achsen Spannungsteiler vorgesehen.

Die Spannungsteiler wurden bewusst so dimensioniert, dass bei einer angenommenen maximalen Eingangsspannung von 5 V nicht der vollständige ADC-Bereich bis 3,3 V ausgenutzt wird. Stattdessen wurde mit einer maximalen Ausgangsspannung von 3,15 V gerechnet. Dadurch bleibt eine zusätzliche Reserve für Bauteiltoleranzen und mögliche Abweichungen der Ausgangsspannung erhalten.

Für den Spannungsteiler gilt allgemein:

U_(ADC) =U_(JS) ⋅(R_2)/(R_1 +R_2)

Mit einer maximal angenommenen Joystickspannung von 5 V und einer gewünschten ADC-Spannung von 3,15 V ergibt sich:

3.15 V=5 V⋅(R_2)/(R_1 +R_2)

Nach der Umstellung ergibt sich für das notwendige Widerstandsverhältnis:

R_1 =R_2 ⋅((5 V)/(3.15 V)-1)

Damit gilt näherungsweise:

R_1 ≈0.587⋅R_2

Für den unteren Widerstand wurde ein verfügbarer Wert von 8,2 kΩ gewählt. Daraus ergibt sich für den oberen Widerstand ein rechnerischer Wert von ungefähr 4,8 kΩ. Als nächstliegender verfügbarer Standardwert wurde 4,7 kΩ verwendet.

R_1 ≈0.587⋅8.2 kΩ≈4.81 kΩ

Mit den tatsächlich eingesetzten Widerständen von 4,7 kΩ und 8,2 kΩ ergibt sich bei einer Eingangsspannung von 5 V eine maximale ADC-Spannung von etwa 3,18 V. Damit bleibt weiterhin ein ausreichender Abstand zur 3,3-V-Grenze des Mikrocontrollers.

Parallel zum unteren Widerstand des jeweiligen Spannungsteilers befindet sich ein Kondensator mit 10 nF. Zusammen mit den Widerständen bildet dieser einen einfachen Tiefpass und reduziert hochfrequente Störungen auf den analogen Joysticksignalen. Dadurch werden die am ADC anliegenden Spannungswerte stabilisiert und die spätere Auswertung in der Software weniger empfindlich gegenüber kurzen Störimpulsen.

Die beiden Joysticktaster werden ebenfalls über den vorhandenen Steckverbinder auf die Platine geführt und über GPIO-Eingänge des STM32 ausgewertet. Für die drei analogen Achsen wurden zusätzlich Testpunkte vorgesehen. Dadurch können die am Mikrocontroller anliegenden Spannungen während der Inbetriebnahme direkt gemessen und die Funktion der Spannungsteiler sowie der Joysticksensoren überprüft werden.

Abbildung 6 zeigt die vollständige Anbindung des Joysticks einschließlich der drei Spannungsteiler, der Filterkondensatoren, der Tasteranschlüsse und der vorgesehenen Testpunkte.

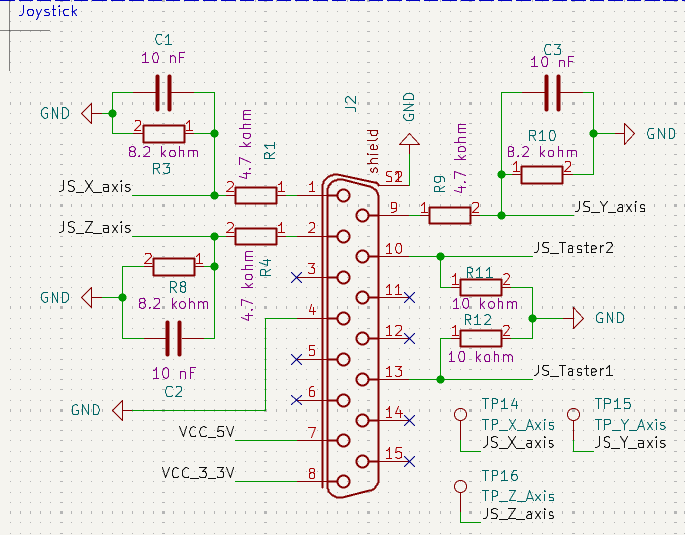
[picture p6: figure]

Abbildung 6, Joystickansteuerung

## 3.6 Programmierschnittstelle

Für die Programmierung und das Debugging des STM32 wurde ein bereits vorhandener ST-LINK/V2 verwendet. Als Schnittstelle wurde SWD gewählt, da hierfür nur wenige Signalleitungen benötigt werden und sich die Verbindung dadurch einfacher umsetzen lässt als beispielsweise mit JTAG. Gleichzeitig bietet SWD alle für die Entwicklung benötigten Funktionen zum Programmieren und Debuggen des Mikrocontrollers.

Die Verbindung zum ST-LINK erfolgt über den Stecker J5. Dabei werden insbesondere die Signale SWDIO, SWCLK und NRST sowie 3,3 V und GND herausgeführt. Zusätzlich ist die SWO-Leitung vorgesehen. Für den Anschluss wurde ein einfacher Steckverbinder aus dem Sortiment von Würth Elektronik verwendet. Die Abbildung 7 zeigt den sehr simplen Aufbau.

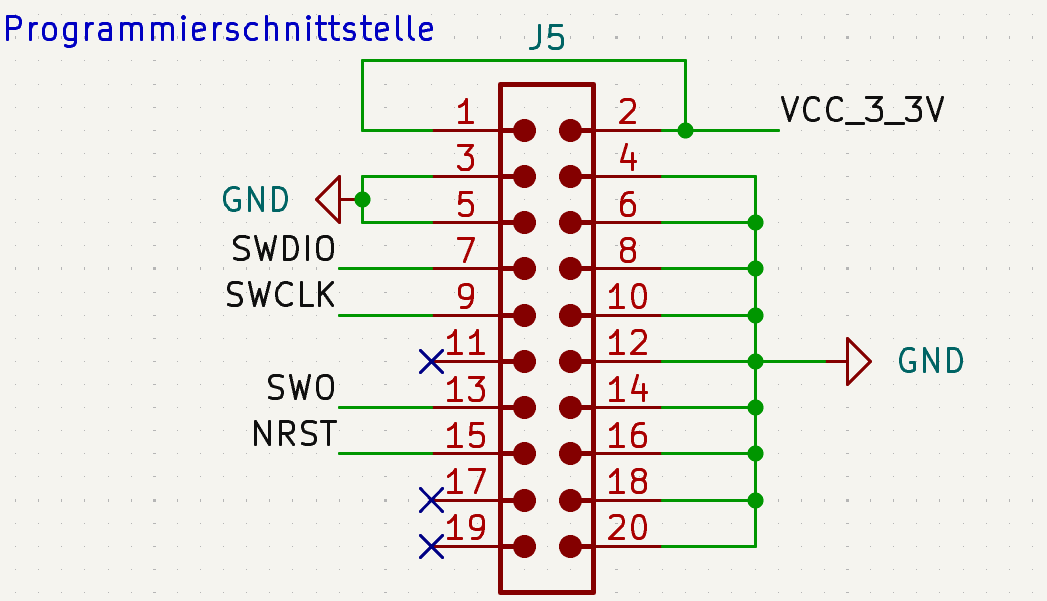
[picture p7: figure]

Abbildung 7, Programmierschnittstelle SWD

Durch die herausgeführte Programmierschnittstelle kann der Mikrocontroller direkt auf der bestückten Platine programmiert und während der Softwareentwicklung debuggt werden, ohne dass zusätzliche Hardwareänderungen notwendig sind.

## 3.7 Displayanschluss

Für die Anzeige der Betriebs- und Statusinformationen wird ein 4×20-Zeichen-Display verwendet. Im Gegensatz zum ursprünglichen Kommunikationsmodul wurde bei der neuen Umsetzung ein Display mit bereits integriertem I²C-Adapter ausgewählt. Dadurch konnte auf einen zusätzlichen Portexpander auf der Platine verzichtet werden, da die Umsetzung der I²C-Signale auf die Displayansteuerung direkt am Display erfolgt.

Für die Verbindung werden daher lediglich vier Leitungen benötigt: 3,3 V, GND sowie die beiden I²C-Signale SDA und SCL. Diese werden über den Steckverbinder J1 von der Platine zum Display geführt. Die für den I²C-Bus erforderlichen Pull-up-Widerstände sind bereits auf dem verwendeten Adaptermodul vorhanden und mussten deshalb nicht zusätzlich auf der Platine vorgesehen werden.

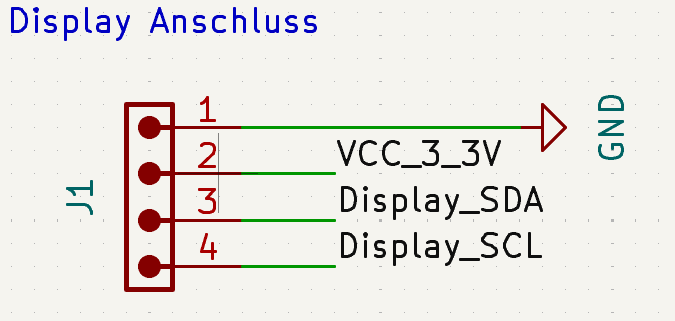
[picture p8: figure]

Abbildung 8, Displayanschluss

Durch diese Lösung konnte die Displayanbindung gegenüber dem ursprünglichen Aufbau vereinfacht und die Anzahl der benötigten Bauteile auf der Platine reduziert werden. Die auf dem Display dargestellten Informationen und deren softwareseitige Ansteuerung werden im entsprechenden Softwarekapitel näher beschrieben.

Nachdem damit alle wesentlichen Schaltungsteile und Schnittstellen beschrieben wurden, wird im folgenden Abschnitt deren Umsetzung im Leiterplattenlayout betrachtet. Dabei steht insbesondere die Platzierung der Bauteile, die Leiterbahnführung und der Aufbau der Masseflächen im Mittelpunkt.

## 3.8 Platinen Layout und Routing

Nach Fertigstellung des Schaltplans wurde das PCB-Layout in KiCad erstellt. Für die Umsetzung wurde eine zweilagige Leiterplatte mit den Kupferlagen F.Cu und B.Cu gewählt. Da die Schaltung aus einer überschaubaren Anzahl von Bauteilen und Signalen besteht, konnten sämtliche Verbindungen auf diesen beiden Lagen realisiert werden. Ein vierlagiger Aufbau hätte für die vorliegende Anwendung keinen wesentlichen zusätzlichen Nutzen geboten und gleichzeitig die Kosten erhöht. Die Leiterplatte besitzt eine Gesamtdicke von ungefähr 1,6 mm und eine Kupferstärke von 35 µm je Lage.

Alle Bauteile befinden sich auf der Oberseite der Leiterplatte. Im Zentrum der Platine wurde der Mikrocontroller U1 angeordnet, sodass die Verbindungen zu den unterschiedlichen Funktionsgruppen in mehrere Richtungen geführt werden können. Die zugehörigen Kondensatoren, Widerstände und der Quarz befinden sich in der näheren Umgebung des Mikrocontrollers. Durch diese Anordnung können insbesondere die Verbindungen des Quarzes und der Versorgungspins kurzgehalten werden.

Die Steckverbinder wurden überwiegend am Rand der Leiterplatte platziert. Der Anschluss des Displays befindet sich an der oberen Seite, während der Joystick über den seitlich angeordneten D-Sub-Steckverbinder angeschlossen wird. Die Anschlüsse für die beiden Motorsteuerungen wurden gemeinsam mit den jeweiligen RS485-Transceivern im unteren Bereich der Platine angeordnet. Dadurch liegen die Transceiver U2 und U3 in der Nähe der zugehörigen Steckverbinder J3 und J4. Die Leitungswege zwischen den Transceivern und den externen Anschlüssen bleiben damit vergleichsweise kurz. Die Programmier- und Debugschnittstelle sowie zahlreiche Testpunkte sind am rechten beziehungsweise linken Platinenrand angeordnet und bleiben dadurch auch bei einer bestückten Leiterplatte gut zugänglich.

Für die Masseführung wurde sowohl auf der Oberseite als auch auf der Unterseite eine großflächige, mit GND verbundene Kupferzone angelegt. Diese Flächen stellen über weite Bereiche der Platine eine niederohmige Masseverbindung bereit und reduzieren die Anzahl separat zu verlegender Masseleitungen. Gleichzeitig ermöglichen sie kurze Rückstrompfade für die Signale. Die beiden Masseflächen sind über eine Vielzahl an GND-Vias miteinander verbunden. Diese Durchkontaktierungen verteilen die Masseverbindung über die Platine und verhindern, dass die beiden Kupferflächen nur an wenigen einzelnen Stellen miteinander verbunden sind. Im Bereich der drei Befestigungsbohrungen wurden auf beiden Kupferlagen Sperrflächen vorgesehen, sodass Leiterbahnen, Vias und Kupferzonen ausreichend Abstand zu den Bohrungen halten.

Bei der Dimensionierung der Leiterbahnen wurde zwischen Signal- und Versorgungsleitungen unterschieden. Für die meisten Kommunikations-, Steuer- und Analogsignale wurde eine Breite von 0,2 mm verwendet. Dazu gehören unter anderem die UART- und RS485-Steuersignale, die SWD-Programmiersignale, die I²C-Leitungen des Displays sowie die analogen Joysticksignale. Da über diese Verbindungen nur geringe Ströme fließen, ist die gewählte Breite für ihre Funktion ausreichend und ermöglicht zugleich ein platzsparendes Routing.

Die Versorgungsleitungen wurden dagegen breiter ausgeführt. Für die 5-V-Versorgung kommt überwiegend eine Leiterbahnbreite von 0,5 mm zum Einsatz. Die 3,3-V-Versorgung wurde abhängig vom jeweiligen Abschnitt mit Breiten zwischen 0,3 mm und 0,75 mm geroutet. In der Nähe des Spannungsreglers wurde zusätzlich eine eigene 3,3-V-Kupferfläche angelegt.

Der überwiegende Teil der Verbindungen wurde auf der Oberseite geführt. Die Unterseite wird ergänzend genutzt, wenn sich Leiterbahnen auf der Oberseite nicht ohne Kreuzungen oder größere Umwege verlegen lassen. Der Wechsel zwischen beiden Lagen erfolgt über Durchkontaktierungen mit einem Durchmesser von 0,7 mm und einer Bohrung von 0,3 mm. Auf diese Weise konnten die notwendigen Verbindungen realisiert werden, ohne einen komplexeren Lagenaufbau einsetzen zu müssen.

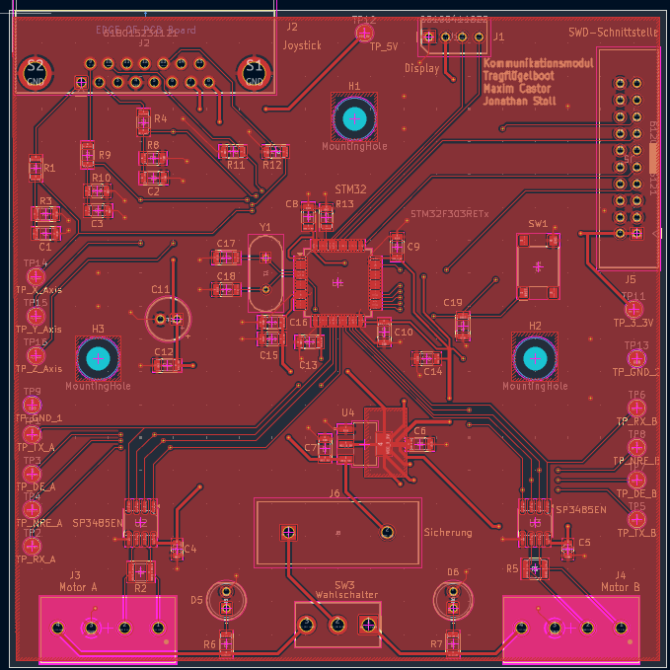
[picture p9: figure]

Abbildung 9, Routing F.Cu

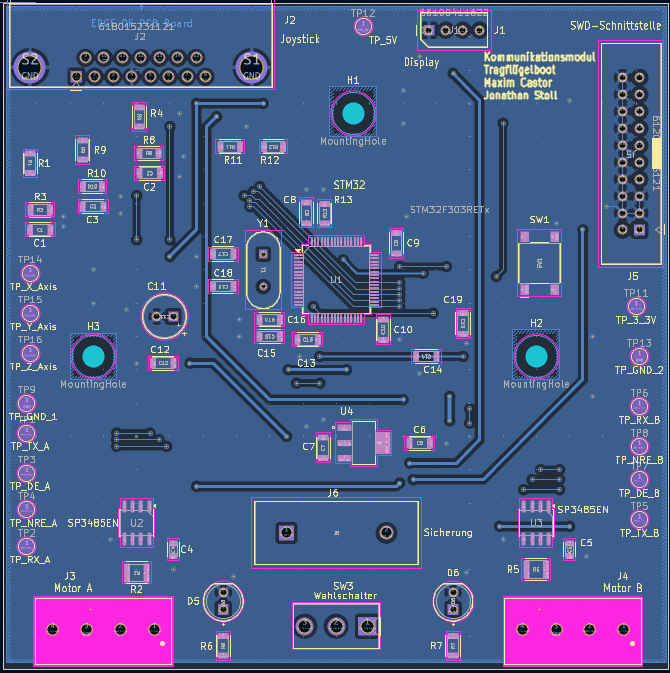
[picture p10: figure]

Abbildung 10, Routing B.Cu

## 3.9 Bestückung der Platine

Da auf der Leiterplatte überwiegend SMD-Bauteile eingesetzt werden, haben wir die meisten Bauteile mit dem Reflow-Verfahren gelötet. Zunächst wurde die Lötpaste mithilfe eines Stencils auf die vorgesehenen Lötflächen aufgetragen. Anschließend wurden die Bauteile auf der Platine positioniert und gemeinsam in einem Reflow-Ofen erhitzt. Das verwendete Temperaturprofil orientierte sich an den Vorgaben der Lötpaste und an der maximal zulässigen Temperatur des empfindlichsten Bauteils, in diesem Fall des Mikrocontrollers. Dadurch sollte eine ausreichende Erwärmung der Lötstellen erreicht werden, ohne die Bauteile thermisch zu überlasten.

Die Steckverbinder wurden nicht im Reflow-Verfahren verarbeitet, sondern nachträglich von Hand eingelötet, da sie die hohen Temperaturen nicht ausgehalten hätten. Anschließend wurden die Bestückung und insbesondere die Lötstellen des Mikrocontrollers visuell kontrolliert.

Beim ersten Bestückungsversuch konnte der Mikrocontroller aufgrund seines geringen Pinabstands nicht ausreichend genau positioniert werden. Da sich das Bauteil anschließend nicht mehr beschädigungsfrei entfernen ließ, wurde diese Platine nicht weiterverwendet. Beim zweiten Versuch wurde daher besonders auf die Ausrichtung des Mikrocontrollers zu den Lötflächen geachtet. Dadurch konnte die Platine erfolgreich bestückt werden. In Der Abbildung 11 ist die fertig bestückte Platine zu sehen.

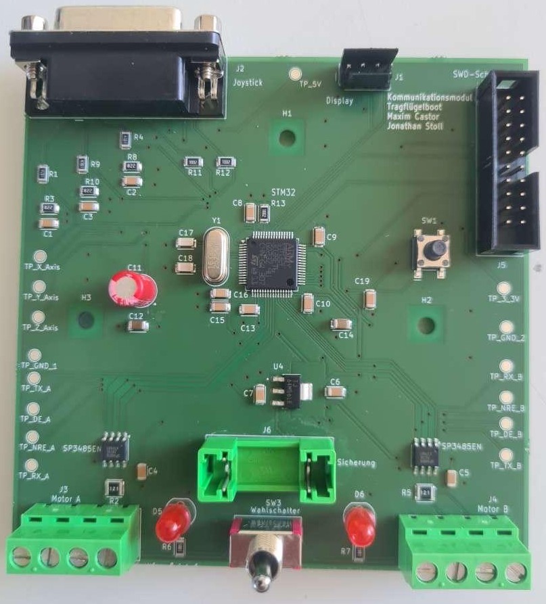
[picture p11: figure]

Abbildung 11, Bestückte Platine

Nach der erfolgreichen Bestückung und Prüfung der Leiterplatte wurde das Kommunikationsmodul schrittweise mit dem Display und den weiteren Komponenten zusammengebaut und anschließend im vorgesehenen Gehäuse befestigt. Das Vorgehen wird in Kapitel 5 näher beschrieben.

# 4 Software

## 4.1 Zusammenfassung

Die Software des Kommunikationsmoduls verbindet den dreiachsigen Joystick, zwei Motorsteuerungen und ein 4×20-Zeichen-Display. Als Mikrocontroller wird ein STM32F303RET6 verwendet. Die X-, Y- und Z-Achse des Joysticks werden über drei ADC-Kanäle eingelesen und auf einen Wertebereich von −127 bis +127 normiert. Aus diesen Werten werden getrennte Steuerwerte für Motor A und Motor B berechnet.

Die Kommunikation mit den beiden Motorsteuerungen erfolgt über zwei voneinander getrennte UART-Schnittstellen mit jeweils 38,4 kBd. Die UART-Signale werden mithilfe zweier RS485-Transceiver in differentielle RS485-Signale umgesetzt. Alle 30 ms wird an jeden Motor ein fünf Byte langes Steuertelegramm übertragen. Gleichzeitig empfängt das Kommunikationsmodul Statusinformationen wie Drehzahl, Leistung, Batteriespannung, Akkustand, Geschwindigkeit, Motortemperatur und Motorfehler.

Die wichtigsten Betriebswerte beider Motoren werden auf einem 4×20-Zeichen-Display dargestellt. Über die beiden Taster des Joysticks kann zwischen zwei Displayseiten sowie zwischen dem normalen Fahrmodus und dem Drehmodus gewechselt werden.

## 4.2 Aufbau der Software

Die selbst entwickelte Anwendungssoftware ist in mehrere Module unterteilt. Dadurch sind die einzelnen Aufgaben voneinander getrennt und können unabhängig nachvollzogen oder verändert werden.

Modul | Aufgabe
main.c | Initialisierung des Mikrocontrollers und Aufruf der Hauptverarbeitung
communication_module.c/.h | Zentrale Ablaufsteuerung und Verknüpfung aller Softwaremodule
joystick.c/.h | Einlesen und Normieren der Joystickachsen und Taster
motor_rs485.c/.h | Senden und Empfangen der RS485-Motortelegramme
display_i2c.c/.h | Ansteuerung des 4×20-Zeichen-Displays über I²C

Tabelle 2, Software Unterteilung

Die übrigen Dateien wurden mithilfe von STM32CubeMX automatisch erzeugt. Die zugehörige Konfigurationsdatei Software_Joystick_Modul.ioc enthält unter anderem die Pinbelegung sowie die Einstellungen von Takt, ADC, DMA, UART, I²C und Interrupts.
Die selbst entwickelten Programmteile befinden sich überwiegend im Verzeichnis Application und sind dadurch von den automatisch generierten Initialisierungsdateien getrennt. Werden die Hardwareeinstellungen später in STM32CubeMX verändert und der Code erneut generiert, bleiben die Dateien im Verzeichnis Application erhalten. Eigene Änderungen innerhalb generierter Dateien sollten dagegen ausschließlich in den dafür vorgesehenen USER CODE-Bereichen vorgenommen werden, da Änderungen außerhalb dieser Bereiche bei einer erneuten Codegenerierung überschrieben werden können.

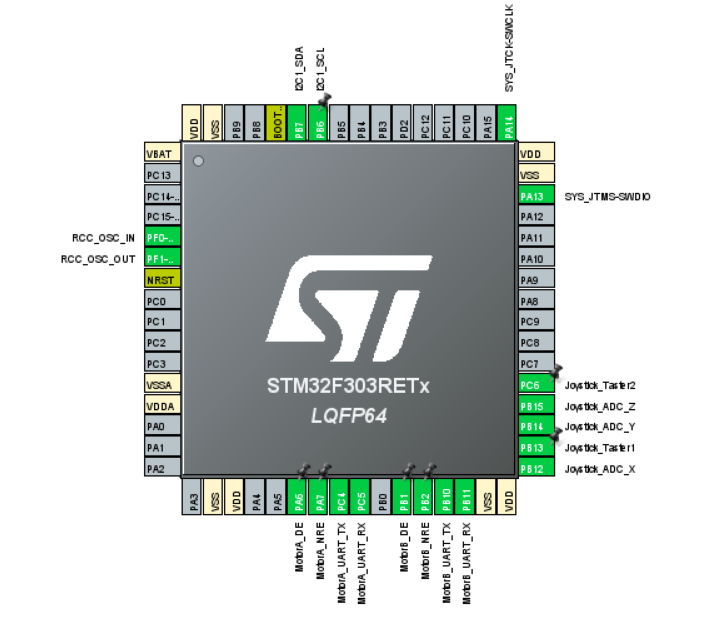
[picture p12: figure]

Abbildung 12, Pin Layout

## 4.3 Initialisierung und Hauptprogramm

Nach einem Neustart wird zunächst die STM32-HAL initialisiert. Anschließend erfolgt die Konfiguration des Systemtakts. Als Taktquelle dient ein externer 16-MHz-Oszillator. Über die PLL wird daraus ein Systemtakt von 64 MHz erzeugt. Die SWD-Schnittstelle bleibt über die Pins PA13 und PA14 verfügbar und ermöglicht das Programmieren und Debuggen des Mikrocontrollers.

Danach werden nacheinander folgende Peripherieeinheiten initialisiert:

1. GPIO-Anschlüsse
2. DMA-Controller
3. ADC4
4. USART1 für Motor A
5. USART3 für Motor B
6. I²C1 für das Display

Nach der Hardwareinitialisierung wird communication_module_init() aufgerufen. Diese Funktion initialisiert die Motorzustände, startet den ADC mit DMA, liest die Taster ein und initialisiert das Display.

Im Anschluss läuft das Programm dauerhaft in einer Endlosschleife:

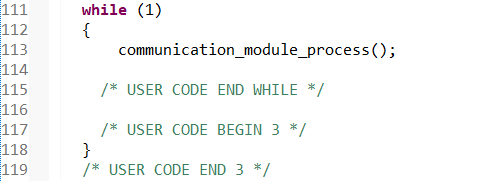
[picture p13: figure]

Abbildung 13, While-Schleife (main.c)

Die Funktion communication_module_process() bildet damit die zentrale Ablaufsteuerung. Sie wertet empfangene Motorframes aus und führt alle 30 ms folgende Schritte aus:

1. Joystick und Taster einlesen
2. Tasteraktionen auswerten
3. Motorsteuerwerte berechnen
4. Steuertelegramm an Motor A senden
5. Steuertelegramm an Motor B senden
6. Display bei Bedarf aktualisieren

Für die zyklische Ablaufsteuerung wird HAL_GetTick() verwendet. Dadurch werden für das 30-ms-Steuerintervall keine festen Wartezeiten mit HAL_Delay() benötigt. Die einzelnen UART- und I²C-Übertragungen werden jedoch weiterhin blockierend ausgeführt. Bei den 30 ms handelt es sich daher um das angestrebte Übertragungsintervall und nicht um eine harte Echtzeitgarantie.

## 4.4 Einlesen des Joysticks

### 4.4.1 ADC- und DMA-Konfiguration

Die drei analogen Joystickachsen werden mit ADC4 gemessen:

ADC-Kanal | Mikrocontrollerpin | Funktion
ADC4_IN3 | PB12 | X-Achse
ADC4_IN4 | PB14 | Y-Achse
ADC4_IN5 | PB15 | Z-Achse

Tabelle 3, ADC-Funktionen

Der ADC arbeitet mit einer Auflösung von 12 Bit. Der theoretische digitale Wertebereich reicht daher von 0 bis 4095. Die drei Kanäle werden kontinuierlich nacheinander gemessen.

Die Ergebnisse werden über DMA direkt in das Array joystick_adc_values geschrieben:

Abbildung 14, Array ADC-Values (joystick.h)

Die Reihenfolge entspricht der ADC-Konfiguration:

Abbildung 15, ADC-Konfiguration (joystick.c)

Der DMA arbeitet im zirkulären Modus. Nach der Messung der Z-Achse beginnt er automatisch wieder mit der X-Achse. Der Prozessor muss dadurch keine einzelne ADC-Messung starten und abwarten, sondern kann jederzeit die aktuellen Messwerte aus dem Speicher lesen.

Vor dem Start der Messung wird der ADC kalibriert. Anschließend startet HAL_ADC_Start_DMA() die kontinuierliche Erfassung.

### 4.4.2 Normierung der Achsen

Die ADC-Rohwerte können nicht direkt, als Motorsteuerwerte verwendet werden. Sie werden daher durch die Funktion scale_axis() auf den Bereich −127 bis +127 umgerechnet.
Im aktuellen Programm werden folgende Kalibrierwerte verwendet:

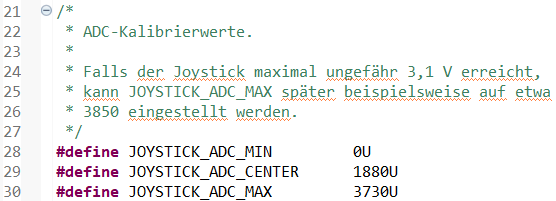
[picture p14: figure]

Abbildung 16, ADC-Kalibrierwerte (joystick.h)

Werte unterhalb der Mittelstellung werden auf den Bereich −127 bis 0 abgebildet:

(ADC_Mitte - ADC_Wert) · 127

Normwert = - ───────────────────────────────

ADC_Mitte - ADC_Minimum

Werte oberhalb der Mittelstellung werden auf den Bereich 0 bis +127 abgebildet:

(ADC_Wert - ADC_Mitte) · 127

Normwert = ────────────────────────────────

ADC_Maximum - ADC_Mitte

Die getrennte Berechnung beider Hälften ist erforderlich, weil die mechanische Mittelstellung nicht zwingend exakt der Hälfte des ADC-Bereichs entspricht.

Zusätzlich wird eine Totzone von ±15 verwendet:

#define JOYSTICK_DEAD_ZONE 15

Alle normierten Werte zwischen −15 und +15 werden auf null gesetzt. Dadurch führen kleine Messwertschwankungen oder eine nicht vollständig exakte mechanische Mittelstellung nicht zu einer unbeabsichtigten Motorbewegung.
Die berechneten Werte werden in folgenden Variablen gespeichert:

con_x

con_y

con_z

## 4.5 Auswertung der Joysticktaster

Die beiden Taster werden als digitale Eingänge mit internen Pull-up-Widerständen verwendet. Im nicht gedrückten Zustand liegt am Eingang ein High-Pegel an. Beim Drücken wird der Eingang mit Masse verbunden. Die Taster sind daher aktiv-low.

Die Software wandelt diese Pegel in einfache nutzbare Zustände um:

0 = Taster nicht gedrückt

1 = Taster gedrückt

Taster 1 wechselt zwischen der Hauptseite und der Detailseite des Displays. Taster 2 schaltet zwischen dem normalen Fahrmodus und dem Drehmodus um.

Die Umschaltung erfolgt nur bei einer neuen Tastenbetätigung. Ein dauerhaft gedrückter Taster löst somit nicht fortlaufend weitere Umschaltungen aus. Für Taster 2 ist zusätzlich eine Entprellzeit von 150 ms vorgesehen.

Nach dem Einschalten muss Taster 2 zunächst losgelassen worden sein. Dadurch wird verhindert, dass beim Programmstart unbeabsichtigt der Drehmodus aktiviert wird.

## 4.6 Berechnung der Motorsteuerwerte

### 4.6.1 Normaler Fahrmodus

Für die nachfolgende Berechnung ist Motor A dem linken Antrieb und Motor B dem rechten Antrieb zugeordnet. Diese Zuordnung muss auch bei der Verkabelung der beiden RS485-Schnittstellen eingehalten werden, da andernfalls die Lenkbewegung vertauscht wird.

Nach dem Einschalten befindet sich das System im normalen Fahrmodus. Dabei bestimmt die Y-Achse den Vorwärts- beziehungsweise Rückwärtsschub:

con_y > 0: Vorwärtsfahrt

con_y < 0: Rückwärtsfahrt

con_y = 0: Stillstand

Die X-Achse bestimmt die Fahrtrichtung:

con_x > 0: Rechtskurve

con_x < 0: Linkskurve

con_x = 0: Geradeausfahrt

Bei Geradeausfahrt erhalten beide Motoren denselben Steuerwert:

Motor A = con_y

Motor B = con_y

Bei einer Kurvenfahrt behält der kurvenäußere Motor den vollständigen Schub. Der kurveninnere Motor wird abhängig von der Auslenkung der X-Achse reduziert:

Reduzierter Motorwert =

con_y × (127 - |con_x|)

────────────────────────

127

Bei halber X-Auslenkung erhält der kurveninnere Motor ungefähr die Hälfte des durch die Y-Achse vorgegebenen Schubs. Bei vollständiger X-Auslenkung wird der kurveninnere Motor auf null reduziert.

Die Zuordnung lautet:

Fahrtrichtung | Motor A | Motor B
Geradeaus | voller Y-Wert | voller Y-Wert
Rechtskurve | voller Y-Wert | reduzierter Wert
Linkskurve | reduzierter Wert | voller Y-Wert

Tabelle 4, Zuordnung Motorwerte nach Fahrtrichtung

Die Tabelle beschreibt zunächst die intern berechneten Motorwerte. Die endgültige Begrenzung auf MOTOR_MAX_POWER erfolgt erst später im RS485-Modul. Liegt ein berechneter Motorwert oberhalb dieser Grenze, wird er vor der Übertragung auf den eingestellten Maximalwert begrenzt.

Die Berechnung wird sowohl bei Vorwärts- als auch bei Rückwärtsfahrt angewendet. Die Z-Achse wird im normalen Fahrmodus vollständig ignoriert.

### 4.6.2 Drehmodus

Der Drehmodus wird über Taster 2 ein- und ausgeschaltet. In diesem Modus werden die X- und Y-Achse ignoriert. Stattdessen steuert die Z-Achse beide Motoren mit entgegengesetzter Drehrichtung:

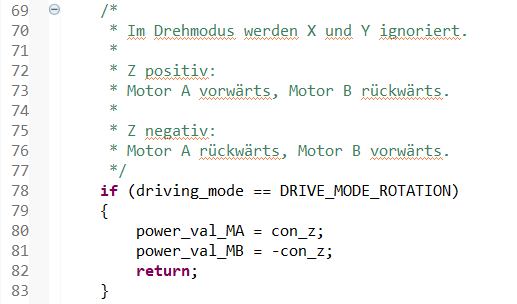
[picture p15: figure]

Abbildung 17, Drehmodus (communication_module.c)

Bei einer positiven Z-Auslenkung fährt Motor A vorwärts und Motor B rückwärts. Bei einer negativen Auslenkung werden beide Drehrichtungen vertauscht. Durch die entgegengesetzten Schubrichtungen kann sich das Boot näherungsweise auf der Stelle drehen.

Nach dem Umschalten zeigt das Display für zwei Sekunden an, welcher Betriebsmodus aktiviert wurde. Danach kehrt es automatisch zur Hauptseite zurück.

## 4.7 Kommunikation mit den Motoren

### 4.7.1 Schnittstellenkonfiguration

Motor A ist über USART1 und Motor B über USART3 angebunden. Beide UART-Schnittstellen verwenden folgende Einstellungen:

Baudrate: 38.400 Bit/s

Datenbits: 8

Parität: keine

Stoppbits: 1

Hardwarefluss: keiner

Da UART selbst keine differentiellen Signale erzeugt, wird pro Kanal ein RS485-Transceiver verwendet. Die Signale DE und /RE schalten den jeweiligen Transceiver zwischen Sende- und Empfangsbetrieb um.

Vor einer Übertragung werden Sender und Sendetreiber aktiviert. Nach Abschluss des Telegramms wird unmittelbar wieder in den Empfangsbetrieb gewechselt.

Der grundlegende Aufbau der fünf Byte langen Datenframes sowie die Berechnung der Prüfsumme wurden bereits in Kapitel 2.3 anhand der aufgezeichneten Motorkommunikation beschrieben. Die Software setzt diesen Aufbau in den Funktionen send_frame_A() und send_frame_B() um. Dort werden Adresse, Befehl und Datenbytes in den Sendepuffer eingetragen und anschließend die Prüfsumme gebildet.

### 4.7.2 Übertragung des Motorwertes

Der berechnete Motorwert liegt zunächst zwischen −127 und +127. Das Vorzeichen und der Betrag werden vor der Übertragung getrennt:

positiver Wert: Richtung = 1

negativer Wert: Richtung = 0

Betrag: absoluter Wert des Motorwertes

Im aktuellen Programm wird der tatsächlich übertragene Betrag zusätzlich auf 80 begrenzt:

Abbildung 18, Maximaler Motorwert (motor_rs485.h)

Auch wenn die Joystickberechnung einen Wert von 127 liefert, wird deshalb maximal 80 an den Motor gesendet.

Die Begrenzung stellt eine zentrale softwareseitige Leistungsbeschränkung dar. Während der Erprobung wird dadurch verhindert, dass über den Joystick unmittelbar der gesamte vom Protokoll mögliche Wertebereich angefordert wird. Die Obergrenze kann später zentral über MOTOR_MAX_POWER angepasst werden.

Die Begrenzung wird für beide Motoren einzeln und erst nach der Lenkberechnung durchgeführt. Werden bei hoher Y-Auslenkung Werte oberhalb von 80 berechnet, werden diese auf 80 begrenzt. Dadurch kann das tatsächlich an die Motoren übertragene Leistungsverhältnis von dem zuvor berechneten Verhältnis abweichen.

Für die Leistungssteuerung wird der Befehl 0x25 verwendet. Ein Motorwert von null wird als Richtung null und Betrag null übertragen. Die Steuertelegramme werden für beide Motoren alle 30 ms neu gesendet.

### 4.7.3 Startsequenz

Die Software verwaltet für jeden Motor einen eigenen Zustandsautomaten:

Zustand | Bedeutung
WAIT_VOLTAGE | Warten auf die Freigabe der Motorsteuerung
STARTING | Startbefehl wird übertragen
READY | Motor ist betriebsbereit
FAULT | Motor hat einen Fehler gemeldet

Tabelle 5, Startsequenz Motorkommunikation

Nach dem Einschalten befindet sich jeder Motor im Zustand WAIT_VOLTAGE. In diesem Zustand sendet das Kommunikationsmodul Leistungsframes mit dem Wert null.

Meldet die Motorsteuerung über das Spannungsstatus-Frame ihre Bereitschaft, wechselt die Software in den Zustand STARTING. Anschließend wird der Motorstartbefehl 0x23 gesendet. Sobald danach ein normales Statusframe empfangen wird, gilt der Motor als betriebsbereit und der Zustand wird auf READY gesetzt.

Meldet der Motor einen Fehler, wird der Zustand FAULT aktiviert. Ab diesem Zeitpunkt sendet die Software den Stoppbefehl 0x26 an den betroffenen Motor.

Erhält die Software im Zustand WAIT_VOLTAGE keine entsprechende Bereitschaftsmeldung, verbleibt der Motor in diesem Zustand und es wird kein Fahrbefehl mit einem von null verschiedenen Leistungswert übertragen. Bei der Fehlersuche kann daher über motor_state_A und motor_state_B geprüft werden, an welcher Stelle der Startsequenz sich die jeweilige Motorsteuerung befindet.

0 = WAIT_VOLTAGE

1 = STARTING

2 = READY

3 = FAULT

### 4.7.4 Empfang der Motordaten

Der Empfang erfolgt Interrupt gesteuert und byteweise. Für Motor A wird USART1 und für Motor B USART3 verwendet. Nach jedem empfangenen Byte wird die HAL-Callback-Funktion aufgerufen.

Am Anfang eines neuen Frames sucht die Software nach der Adresse 0xC5. Bytes mit einem anderen Wert werden verworfen. Nach Erkennung der Adresse werden insgesamt fünf Byte in den jeweiligen Empfangspuffer geschrieben:

Abbildung 19, Receive Buffer (motor_rs485.h)

Sobald ein vollständiges Frame vorliegt, wird das Kennzeichen frame_ready_A beziehungsweise frame_ready_B gesetzt. Die eigentliche Auswertung findet anschließend in der Hauptschleife statt. Zuerst wird die Prüfsumme kontrolliert. Nur gültige Frames werden weiterverarbeitet. Für Diagnosezwecke zählt die Software sowohl gültige Frames als auch Prüfsummenfehler.

Die HAL-Funktion HAL_UART_RxCpltCallback() wird nach jedem vollständig empfangenen Byte aufgerufen. Sie leitet den Aufruf zunächst an das Kommunikationsmodul und anschließend an das RS485-Modul weiter. Dort wird anhand des übergebenen UART-Handles unterschieden, ob das Byte zu Motor A oder Motor B gehört.

Aus den beiden Datenbytes wird bei den meisten Statuswerten ein 14-Bit-Wert zusammengesetzt:

Wert = (DataH AND 0x7F) × 128 + DataL

Die Software wertet gezielt folgende Statusinformationen aus:

Befehl | Information | Interne Einheit
0x20 | Motordrehzahl | 1 rpm
0x21 | Motorleistung | 1 W
0x1D | Batteriespannung | 0,1 V
0x1E | Batteriekapazität | 1 %
0x26 | Geschwindigkeit | 0,1 m/s
0x23 | Motortemperatur | 0,1 °C
0x22 | Motorstatus beziehungsweise Fehler | Bitcodierter Fehlerwert

Tabelle 6, Statusinformationen Motor

Nicht benötigte beziehungsweise unbekannte Statusframes werden ignoriert. Sie beeinträchtigen dadurch die gespeicherten Anzeigewerte nicht.

Bis zum Empfang des ersten gültigen Statusframes besitzen die gespeicherten Motorwerte den Initialwert null. Wird die Kommunikation später unterbrochen, bleiben die zuletzt gültig empfangenen Werte im aktuellen Programm gespeichert. Die Displayanzeige allein zeigt deshalb nicht sicher an, ob weiterhin neue Frames empfangen werden. Zur Kontrolle müssen zusätzlich die Zähler valid_frames_A und valid_frames_B beobachtet werden. Diese müssen während einer funktionierenden Kommunikation kontinuierlich ansteigen.

Die Variablen checksum_errors_A und checksum_errors_B zählen Frames mit fehlerhafter Prüfsumme. Steigen diese Werte an, deutet dies beispielsweise auf eine gestörte RS485-Übertragung, eine fehlerhafte Verdrahtung oder falsche Schnittstelleneinstellungen hin.

## 4.8 Fehlerbehandlung

Das Motorstatus-Frame 0x22 wird auf einen Fehlerwert geprüft. Ein von null verschiedenem Wert versetzt den entsprechenden Motor in den Zustand FAULT.

Die Fehler sind bitcodiert:

Fehlerwert | Bedeutung
0x01 | Kommunikationsfehler
0x02 | Überspannung
0x04 | Unterspannung
0x08 | Überstrom
0x10 | Motor blockiert

Tabelle 7, Motorfehler

Da es sich um einzelne Bits handelt, können theoretisch mehrere Fehler gleichzeitig auftreten. In diesem Fall ergibt sich der Fehlerwert aus der Summe der gesetzten Bits.

Bei einem UART-Fehler wird der unvollständige Empfang verworfen, der Empfangsindex auf null gesetzt und der interruptgesteuerte Empfang neu gestartet. Frames mit fehlerhafter Prüfsumme werden ebenfalls verworfen.

Tritt bereits während der Initialisierung einer Hardwarekomponente ein Fehler auf, wird Error_Handler() aufgerufen. Diese Funktion deaktiviert die Interrupts und hält das Programm in einer Endlosschleife an.

Der Zustand FAULT bleibt im aktuellen Programm gespeichert, auch wenn später ein fehlerfreies Motorstatus-Frame empfangen wird. Während dieses Zustands wird an den betroffenen Motor fortlaufend der Stoppbefehl übertragen. Das Zurücksetzen des Fehlerzustands erfolgt erst durch eine erneute Initialisierung des Kommunikationsmoduls beziehungsweise durch einen Neustart des Mikrocontrollers. Vor einem Neustart muss zunächst die Ursache des Motorfehlers beseitigt werden.

Bei einer Fehlerdiagnose werden zunächst motor_state_A beziehungsweise motor_state_B und anschließend motor_fault_A beziehungsweise motor_fault_B geprüft. Der Motorzustand zeigt, ob die Software einen Fehler erkannt hat. Der Fehlerwert enthält die vom Motor gemeldete Ursache.

## 4.9 Displayansteuerung

Das verwendete 4×20-Zeichen-Display basiert auf dem HD44780-Controller und besitzt ein PCF8574-I²C-Backpack. Das Display wird über I²C1 an den Pins PB6 und PB7 angesteuert. Die konfigurierte I²C-Adresse lautet 0x27.

Das I²C-Backpack überträgt die Displaydaten im 4-Bit-Modus. Jedes Byte wird deshalb in zwei Gruppen zu je vier Bit aufgeteilt. Über die Enable-Leitung wird dem Display signalisiert, wann es die anliegenden Daten übernehmen soll.

Bei der Initialisierung prüft die Software zunächst, ob das Display unter der erwarteten I²C-Adresse erreichbar ist. Anschließend wird der HD44780-Controller in den 4-Bit-Modus versetzt, der Cursor ausgeschaltet und das Display gelöscht.

Die Funktion Display_WriteLine() schreibt immer genau 20 Zeichen. Kürzere Texte werden mit Leerzeichen aufgefüllt und längere Texte nach 20 Zeichen abgeschnitten. Dadurch bleiben keine Zeichen eines vorherigen, längeren Textes auf dem Display stehen.

Kann das Display nicht initialisiert werden, läuft die Motorsteuerung trotzdem weiter. Das Display ist daher keine zwingende Voraussetzung für die eigentliche Steuerfunktion.

Das Display kann auch ohne angeschlossene Motorsteuerungen getestet werden. In diesem Fall wird es normal initialisiert, die noch nicht empfangenen Motorwerte werden jedoch mit null dargestellt. Die Motorzustände verbleiben ohne Antwort der Motorsteuerungen im Zustand WAIT_VOLTAGE.

## 4.10 Displayinhalte

### 4.10.1 Hauptseite

Die Hauptseite stellt für Motor A und Motor B die drei wichtigsten Betriebswerte dar:

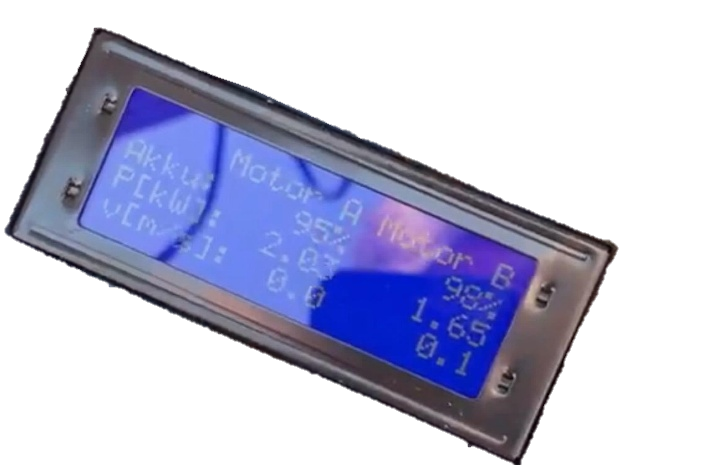
[picture p16: figure]

Motor A Motor B

Akku: % %

P[kW]:

v[km/h]:

Abbildung 20, Display Hauptseite

Angezeigt werden:

- Batteriekapazität in Prozent
- Motorleistung in Kilowatt
- Geschwindigkeit in Kilometer pro Stunde

Die Motorleistung wird in Watt empfangen und für die Darstellung in Kilowatt umgerechnet.

Die Geschwindigkeit wird vom Motor in Schritten von 0,1 m/s übertragen. Für die Anzeige erfolgt die Umrechnung:

Geschwindigkeit in km/h =

Geschwindigkeit in m/s × 3,6

Die Umrechnung wird mit Ganzzahlen durchgeführt, damit auf dem Mikrocontroller keine Gleitkommaberechnung erforderlich ist.

### 4.10.2 Detailseite

Durch Drücken von Taster 1 wird die Detailseite geöffnet:

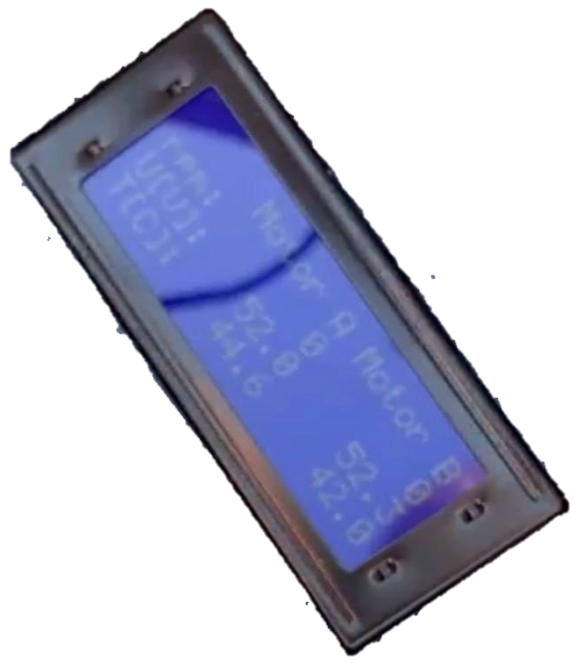
[picture p17: figure]

Motor A Motor B

rpm:

U[V]:

T[C]:

Abbildung 21, Display Detailseite

Sie zeigt für beide Motoren:

- Motordrehzahl in Umdrehungen pro Minute
- Batteriespannung in Volt
- Motortemperatur in Grad Celsius

Durch erneutes Drücken von Taster 1 wird wieder die Hauptseite angezeigt.

### 4.10.3 Modusmeldung und Fehleranzeige

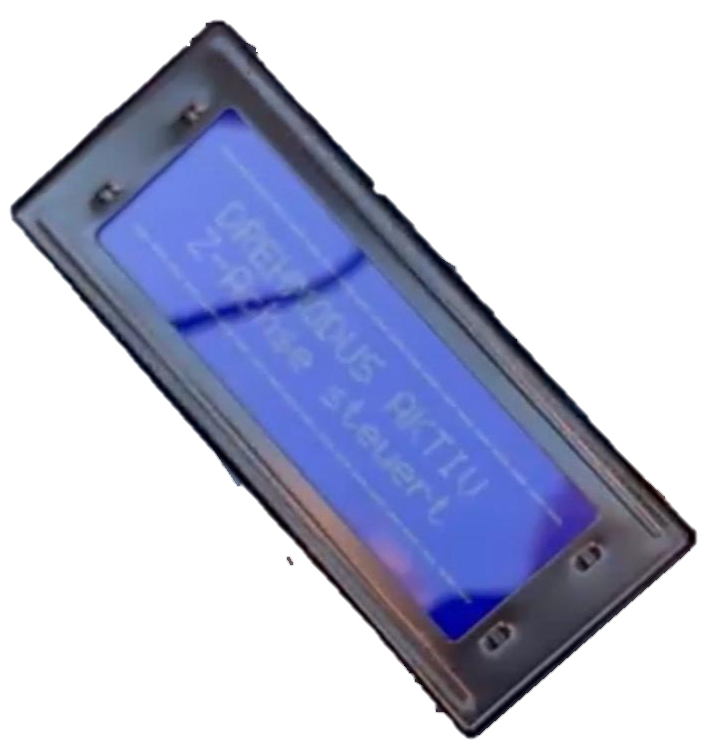
[picture p18: figure]

Beim Umschalten des Fahrmodus zeigt das Display für zwei Sekunden eine Meldung an:

DREHMODUS AKTIV

Z-Achse steuert

Abbildung 22, Anzeige Drehmodus

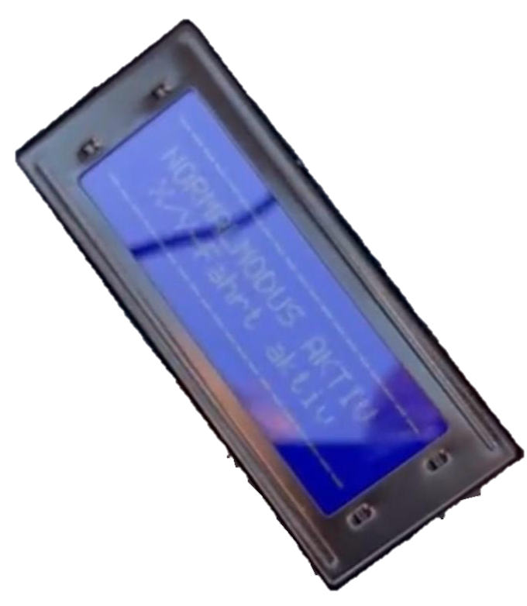
[picture p19: figure]

beziehungsweise:

NORMALMODUS AKTIV

X/Y-Fahrt aktiv

Abbildung 23, Anzeige Normalmodus

Danach wird automatisch wieder die Hauptseite dargestellt.

Sobald mindestens ein Motor den Zustand FAULT erreicht, hat die Fehlerseite Vorrang vor allen normalen Anzeigen. Sie nennt Motor A beziehungsweise Motor B und zeigt den erkannten Fehler mit Fehlercode an. Zusätzlich wird der Hinweis ausgegeben, die Motoren auszuschalten.

## 4.11 Zeitlicher Gesamtablauf

Die wichtigsten Vorgänge verwenden unterschiedliche Aktualisierungszeiten:

Vorgang | Zeitintervall
Einlesen und Verarbeiten des Joysticks | 30 ms
Senden der Motorsteuerwerte | 30 ms
Normale Displayaktualisierung | 250 ms
Anzeige einer Modusmeldung | 2000 ms
Entprellzeit von Taster 2 | 150 ms

Tabelle 8, Zeitlicher Gesamtablauf

Der Empfang der Motorframes erfolgt unabhängig davon interruptgesteuert. Die Auswertung eines vollständig empfangenen Frames wird bei jedem Durchlauf der Hauptschleife angestoßen und ist deshalb nicht auf das 30-ms-Steuerintervall beschränkt.

Zusammengefasst ergibt sich folgender Datenfluss:

Joystick

↓

ADC und DMA

↓

Normierung auf −127 bis +127

↓

Auswahl des Fahrmodus

↓

Berechnung der Werte für Motor A und Motor B

↓

Begrenzung des Betrags auf maximal 80

↓

Übertragung als 5-Byte-RS485-Frame

↓

Motorsteuerungen

↓

Rückübertragung der Statusframes

↓

Prüfsummenprüfung und Auswertung

↓

Darstellung der Betriebs- oder Fehlerwerte auf dem Display

# 5 Systemtests und Praxiserprobung

Die Inbetriebnahme des Kommunikationsmoduls erfolgte schrittweise. Zunächst wurden die grundlegenden Hardwarefunktionen geprüft. Anschließend wurden die Software und die RS485-Kommunikation getestet. Zum Abschluss wurde das Gesamtsystem mit beiden Motoren auf dem Boot erprobt. Dadurch konnten Fehler zunächst einzelnen Komponenten zugeordnet und anschließend unter realen Betriebsbedingungen untersucht werden.

## 5.1 Hardwareprüfung

Zu Beginn wurden der Wahlschalter und die Sicherung mithilfe einer Durchgangsprüfung mit dem Multimeter überprüft. Dabei wurde festgestellt, dass bei einer Auslenkung des Schalters nach rechts der linke Motor ausgewählt wird. Bei einer Auslenkung nach links wird entsprechend der rechte Motor ausgewählt. Diese Zuordnung musste bei der weiteren Inbetriebnahme berücksichtigt werden.

Anschließend wurde die Platine mit einem Labornetzteil mit 5 V versorgt. An den dafür vorgesehenen Testpunkten wurden die 5V- und die 3,3V-Spannung gemessen. Dadurch konnte überprüft werden, ob die Versorgungsspannung korrekt auf der Platine anliegt und der Spannungsregler die benötigten 3,3 V für den Mikrocontroller bereitstellt.

Bevor der Joystick mit der Platine verbunden wurde, wurde der vorgesehene Spannungsteiler zunächst von Hand auf einem Steckbrett aufgebaut. Der Joystick wurde über das Labornetzteil versorgt und seine drei analogen Ausgänge für die X-, Y- und Z-Achse wurden mit dem Spannungsteiler verbunden. Die Ausgangssignale wurden anschließend mit einem Oszilloskop untersucht. Dabei wurde kontrolliert, ob sich die Spannungen entsprechend der Joystickbewegung verändern und ob der Spannungsteiler die Signale auf den zulässigen Eingangsspannungsbereich des Mikrocontrollers begrenzt.

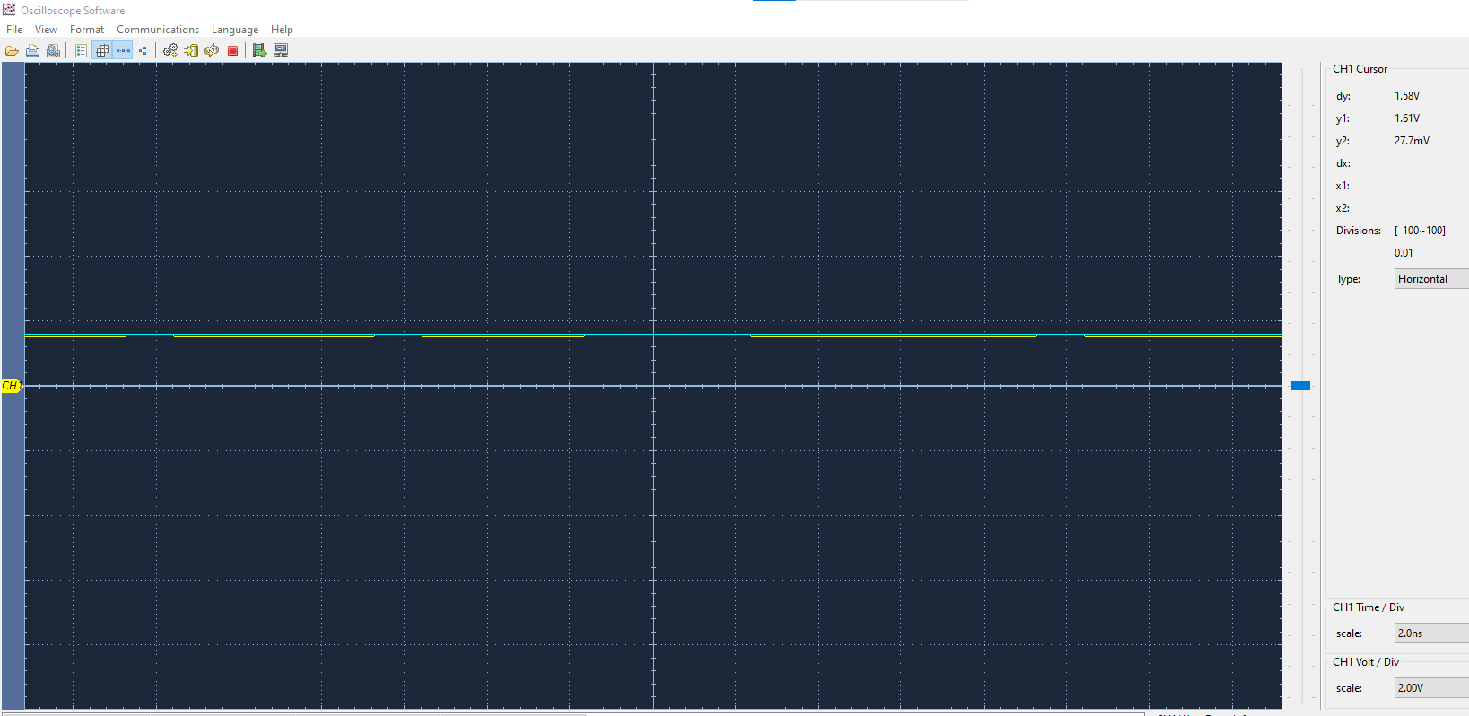
[picture p20: figure]

Abbildung 24, Spannungsteiler Mittelposition

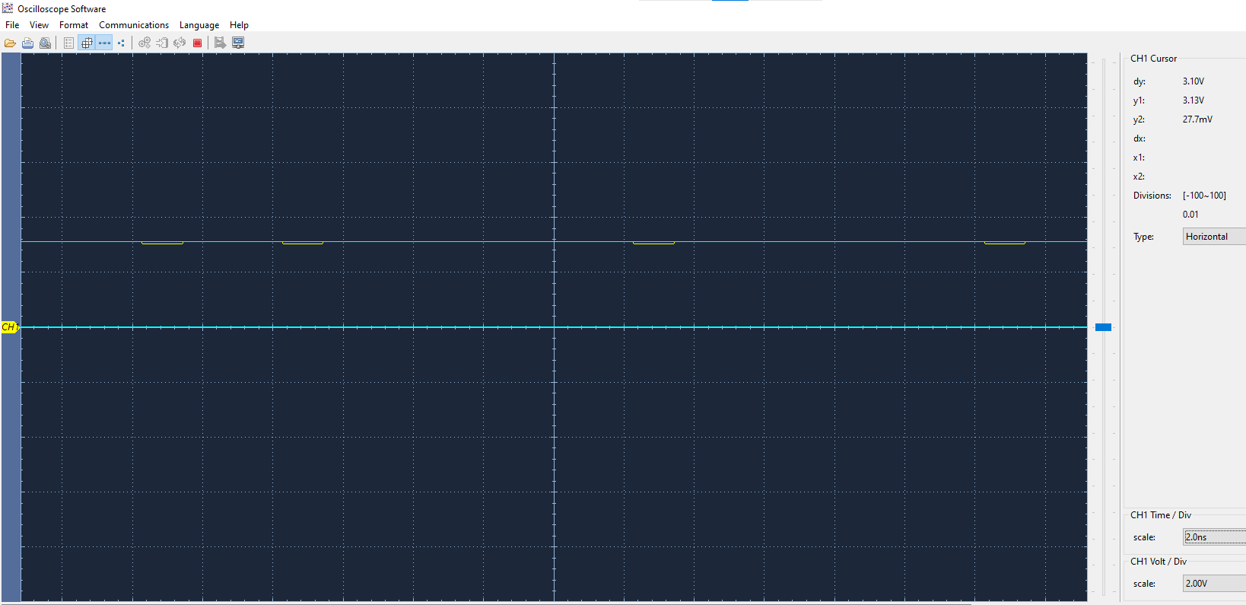
[picture p21: figure]

Abbildung 25, Spannungsteiler maximale Auslenkung

Es ist zu erkennen das der Joystick bei maximaler Auslenkung ca. 3,13V ausgibt. In der Mittelstellung sind dies ca. 1,61V. Daraufhin wurden die Tests auch ohne Spannungsteiler ausgeführt. Dabei war zu erkennen das der angegebene Wert von 4,6V in der Bachelorarbeit falsch war. In maximaler Auslenkung waren es dabei nämlich ca. 5V und in der Mittelstellung ca. 2,5V.

Nach erfolgreicher Prüfung des Versuchsaufbaus wurde der Joystick mit der Platine verbunden. Die Versorgungsspannungen und die drei analogen Joysticksignale wurden erneut an den zugehörigen Testpunkten kontrolliert. Dadurch konnte bestätigt werden, dass die zuvor auf dem Steckbrett überprüfte Schaltung auch auf der gefertigten Platine ordnungsgemäß funktioniert.

## 5.2 Software- und Kommunikationstest

Für die Überprüfung der RS485-Kommunikation wurde das bereits vorhandene STM32-Testmodul verwendet. Dieses Modul war zuvor eingesetzt worden, um die zwischen Motor und Kommunikationsmodul übertragenen RS485-Daten mitzulesen. Für den Funktionstest wurde die Software des Testmoduls so erweitert, dass es Daten sowohl empfangen als auch senden konnte.

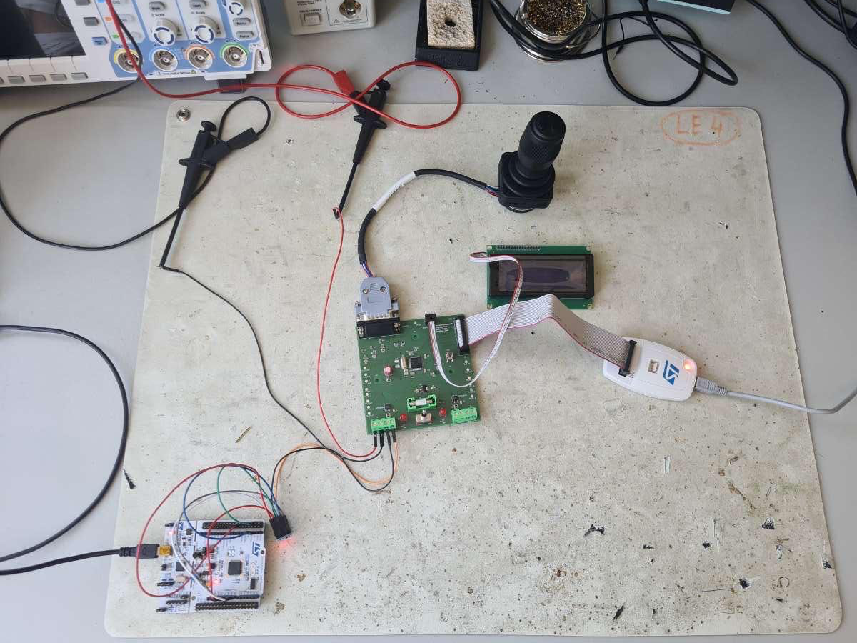
[picture p22: figure]

Abbildung 26, Aufbau Kommunikationsversuch

Während des Tests arbeitete eine Person mit dem Testmodul, während eine zweite Person das entwickelte Kommunikationsmodul überwachte. Beide Seiten sendeten und empfingen Daten. Dadurch konnte unabhängig vom späteren Einsatz auf dem Boot überprüft werden, ob die RS485-Schnittstellen in beide Richtungen funktionieren.

Auf der Sendeseite wurde kontrolliert, ob das Kommunikationsmodul die berechneten Motorsteuerwerte korrekt in die vorgesehenen Frames einträgt und über den jeweiligen RS485-Kanal überträgt. Auf der Empfangsseite wurde geprüft, ob die gesendeten Motordaten korrekt eingelesen, den richtigen Motoren zugeordnet und anschließend von der Software verarbeitet werden. Auf diese Weise konnten sowohl die Hardware der beiden RS485-Kanäle als auch die zugehörige Software getestet werden.

Als letzter Funktionstest wurde das Display an den vorgesehenen Anschluss der Platine angeschlossen. Anschließend wurde kontrolliert, ob die empfangenen Daten korrekt dargestellt werden. Die Anzeige wurde danach mehrfach angepasst, damit die Informationen kompakt und übersichtlich auf dem 4×20-Zeichen-Display erscheinen. In der Hauptansicht werden für beide Motoren Akkustand, Leistung und Geschwindigkeit angezeigt. Eine zweite Ansicht enthält Drehzahl, Batteriespannung und Motortemperatur.

## 5.3 Einbau und Erprobung auf dem Boot

Vor der Erprobung auf dem Boot wurden die einzelnen Komponenten in das dafür vorgesehene Gehäuse eingebaut. Die Platine wurde über ihre drei Befestigungsbohrungen mit drei Schrauben im Gehäuse befestigt. Der Joystick wurde in den Deckel eingesetzt und das Display in der dafür vorgesehenen Aussparung angebracht. Zusätzlich wurden Öffnungen für die beiden Motorkabel hergestellt und mit wasserdichten Kabelverschraubungen versehen. Das Display wurde zunächst nur eingesetzt und nach Abschluss der Funktionstests endgültig befestigt.

Nach den Einzelprüfungen wurde das Kommunikationsmodul gemeinsam mit beiden Motoren auf dem Boot getestet. Bei den ersten Versuchen wurde das Programm im Debug-Modus gestartet und das Kommunikationsmodul über einen Laptop überwacht. Dabei wurden verschiedene interne Variablen und Datenfelder beobachtet, um die korrekte Verarbeitung der Mess- und Motordaten zu überprüfen und mögliche Fehler leichter erkennen zu können. Dazu gehörten unter anderem die ADC-Rohwerte des Joysticks, die daraus berechneten Motorsteuerwerte, die empfangenen Datenframes sowie die Statusvariablen beider Motoren.

Nachdem die grundlegenden Funktionen erfolgreich überprüft worden waren, wurde die endgültige Programmversion dauerhaft in den Flash-Speicher des Mikrocontrollers übertragen. Der abschließende Test erfolgte anschließend ohne angeschlossenen Laptop und ohne aktive Debug-Verbindung, sodass das Kommunikationsmodul unter den vorgesehenen Betriebsbedingungen getestet werden konnte.

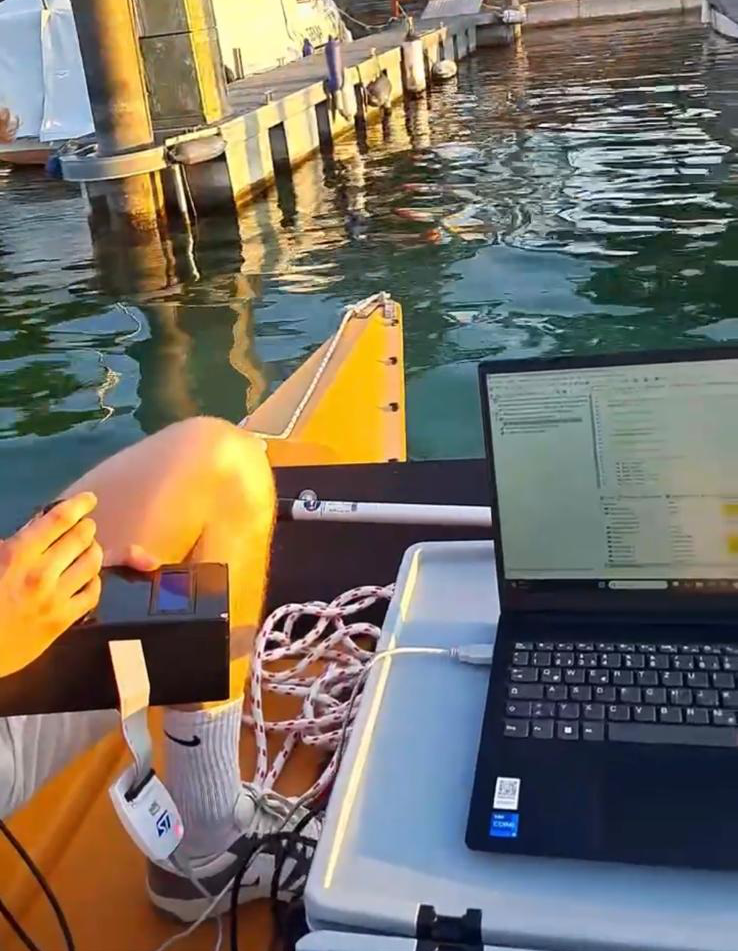
[picture p23: figure]

Abbildung 27, Probefahrt auf dem Wasser

Während der ersten Fahrversuche funktionierten die Ansteuerung und die Anzeige zunächst wie vorgesehen. Nach einiger Betriebszeit wechselten jedoch beide Motoren in den Fehlerzustand und stellten den Betrieb ein. Zunächst wurde vermutet, dass die Ursache in der RS485-Kommunikation oder in den beiden unabhängig laufenden 30-ms-Zyklen lag.

Bei der anschließenden Überprüfung der Versorgungsspannungen wurde festgestellt, dass eine der Batterien nur noch eine Spannung von ungefähr 11V aufwies. Dadurch fiel die Versorgung der Motoren unter die erforderliche Mindestspannung von ungefähr 39V. Der angezeigte Fehlerzustand wurde somit nicht durch eine zeitliche Verschiebung der Kommunikation, sondern durch eine Unterspannung verursacht.

Bei den Fahrversuchen zeigte sich außerdem, dass die Motoren bei hoher Leistung zu viel Luft ansaugten. Deshalb wurde eine Begrenzung des maximalen Motorsteuerwerts in der Software vorgesehen. Dadurch sollte die verfügbare Leistung an den praktischen Aufbau des Bootes angepasst und ein ungünstiger Betrieb der Propeller verhindert werden.

Zusätzlich wurde das Kurvenverhalten untersucht. Zunächst wurde versucht, den kurveninneren Motor rückwärts laufen zu lassen, während der kurvenäußere Motor weiterhin vorwärts angetrieben wurde. Dieses gegenläufige Drehen verbesserte die Kurvenfahrt jedoch nicht wesentlich. Der Rotationsmodus, bei dem beide Motoren gezielt in entgegengesetzte Richtungen laufen, funktionierte dagegen für eine Drehung auf der Stelle.

Die Versuche deuten darauf hin, dass die eingeschränkte Kurvenfahrt nicht hauptsächlich durch die Berechnung der Motorwerte verursacht wird. Als wahrscheinlichere Ursache wurden die Positionen der beiden Motoren und der mechanische Aufbau des Bootes erkannt. Für die normale Kurvenfahrt wurde deshalb wieder die Variante verwendet, bei der die Leistung des kurveninneren Motors reduziert wird und dieser bei vollständiger Lenkauslenkung stehen bleibt.

# 6 Fazit

Das Ziel dieser Projektarbeit wurde erreicht: Das entwickelte Kommunikationsmodul funktioniert zuverlässig und erfüllt alle Anforderungen, die für die Steuerung der beiden Motoren festgelegt wurden. Die Bewegungen des Joysticks werden korrekt verarbeitet, die berechneten Steuerwerte über RS485 an die Motoren übertragen und die empfangenen Betriebsdaten übersichtlich auf dem Display dargestellt. Auch der eigenständige Betrieb ohne Laptop und Debug-Verbindung funktioniert wie vorgesehen.

Um dieses Ergebnis zu erreichen, wurde das bisherige Konzept deutlich vereinfacht und an unser Boot angepasst. Das Kommunikationsmodul aus der Bachelorarbeit war für bis zu vier Motoren ausgelegt und bestand aus zwei übereinander angeordneten Platinen mit einem Master-Slave-Prinzip. Da unser Boot nur zwei Motoren besitzt, wurden diese Erweiterungsmöglichkeiten weggelassen. Dadurch ist das neue Modul kompakter aufgebaut und konzentriert sich auf die tatsächlich benötigten Funktionen.

Die wichtigste technische Veränderung war der Wechsel auf den STM32F303RET6. Aufgrund seines Spannungsbereichs von 3,3 V mussten vor allem die Joysticksignale mithilfe von Spannungsteilern angepasst werden. Zusätzlich wurden die Pinbelegung, die Taktkonfiguration, die Schnittstellen und die Verarbeitung der ADC-Werte überarbeitet. Auch bei der Software wurden nicht benötigte Funktionen entfernt und die Anzeige auf die wichtigsten Motordaten reduziert.

Neu hinzugekommen sind die Ansteuerung des Displays über I²C, zwei übersichtliche Displayansichten und ein Rotationsmodus, bei dem die Motoren über die Z-Achse in entgegengesetzte Richtungen angesteuert werden. Außerdem wurde die maximale Motorleistung begrenzt, nachdem sich bei den Tests gezeigt hatte, dass die Propeller bei hoher Leistung Luft ansaugen.

Trotz des erfolgreichen Ergebnisses kann das System zukünftig weiter verbessert werden. Am Kommunikationsmodul wären beispielsweise eine genauere Anzeige der Motorfehler, eine Warnung bei niedriger Batteriespannung und eine Anbringung des Wahlschalters und des Reset-Knopfes an die Außenseite des Moduls. Am Boot besteht vor allem bei der Kurvenfahrt noch Verbesserungspotenzial. Da das Rückwärtsdrehen des kurveninneren Motors keine deutliche Verbesserung brachte, liegt die Ursache vermutlich hauptsächlich in der Position und dem geringen Abstand der Motoren. Eine andere Motoranordnung oder zusätzliche Lenkflächen könnten das Fahrverhalten verbessern.

Insgesamt ist eine kompakte und auf das Wesentliche reduzierte Lösung entstanden, die die geplanten Funktionen erfüllt und gleichzeitig eine gute Grundlage für zukünftige Erweiterungen bietet.
