Maxim-1301/Projektarbeit_Joystick/Sonstiges/Hinweise zu Bauteilgruppen in KiCad.odt

Hinweise zu Bauteilgruppen in KiCad

Vor Beginn auswählen, wo Bauteile bestellt werden sollen, dann die entsprechenden Bibliotheken hinzufügen, damit die Bauteile alle den richtigen Footprint fürs PCB-Layout haben.

1. RS485 Module
- RS485 Leitung hat einen Wellenwiderstand von 120 Ohm, damit muss die Leitung mit einem Abschlusswiderstand von 120 Ohm terminiert werden
- Abschlusswiderstand muss zwischen Leitungen A und B platziert werden, direkt an das Transceiver Modul platziert werden
2. Joystick
- Sub-D Buchse mit 15 Pins verwenden, für einen robusteren Anschluss, im Labor nachschauen welcher Stecker verwendet wurde und überlegen, ob wir denselben nehmen können
- Spannungsteiler wie in der OneNote Zeichnung einbauen, mit den entsprechenden Widerständen: R1= 4,7kOhm und R2= 10kOhm
- Richtige Stelle mit dem ADC verbinden, siehe Zeichnung
- Die Knöpfe auf die GPIO-Pins setzten, die in der Excel vermerkt sind
- Wichtig: Pull-Up Widerstand setzten und den Common Button auf Ground setzten
- Zusätzliche Kondensatoren mit einbauen, die mit R2 als Tiefpass agieren könne, entlasten den ADC-Eingang bei Spannungseinbrüchen
- SUB-D Stecker verwende, mit 16 Pins
3. Display
- Display so anschließen, wie in der Excel hinterlegt wurde
- Für Hintergrundbeleuchtung: LCD_BL_A nicht direkt an 5V anschließen
- (5V-3,9V) / 150mA= 7.33 Ohm, dann lieber 10 Ohm wählen, dann sind wir auf der sicheren Seite
- An LCD_VEE die 3.3V anschließen und einen Poti mit einbauen, wie im Schaltbild des Datenblatt
- Wannenstecker nutzen
- Zwei separate Stecker verwenden, einen auf die linke Pinleiste, einen auf die rechte Pinleiste leiten
- Falls bessere Lösung vorhanden ist, nutzen
4. SWD-Programmierschnittstelle
