Maxim-1301/Projektarbeit_Joystick/BOM/BOM_Platine.xlsx

Bauteilgruppe | Bauteile | Charakteristik | Beschreibung | Hersteller | Bauteilnummer | Stückzahl | Bestellstückzahl | Slotnummer
STM32F303 | Kondensatoren | 100nF | Nahe an Controller, zwischen Vcc und Gnd | Würth | 885012208030 | 4 |  | 6
 | Kondensatoren | 4,7 µF | Vor Controller, an 3.3V Schiene, bevor aufteilung an Vcc Pins des Controllers | Würth | 885012208040 | 1 |  | 7
 | Kondensatoren | 10nF | Zwischen VDDA und VSSA (ADC Versorgungs) | Würth | 885012208026 | 1 |  | 8
 | Kondensatoren | 1µF | parallel zu 10nF | Würth | 885012208036 | 1 |  | 11
 | SWD-Buchsenleiste | 20 pins | - | Würth | 612020235121 | 1
 | Taster | Höhe= 8mm | ResetTaster | Würth | 430182080816 | 1
 | Widerstand | 10 kOhm | Pull-Down Widerstand für Boot0 Pin | Würth | 560112132018 | 1
 | Quartz | 16 MHz | Externer Quartz Kristall Oscillator für Taktgebung | Würth | 830058383B | 1
 | Lastkapazitäten | 20pF und 22pF | kondensatoren für OSC_in und OSC_out | Würth | 885012008011 | jeweils 2 |  | 9
Joysticks | Female DSUB | 15 Pins | Female Stecker für Joystick | Würth | 618015231121 | 1
 | Widerstand R2.1 | 8,2 kOhm | R1 des Spannungsteilers am Joystick | Würth | 560112132051 | 3 |  | 4
 | Widerstand R2 | 10 kOhm | R2 des Spannungsteilers am Jystick | Würth | 560112132018 | 3
 | Widerstand R1 | 4,7 kOhm | weniger puffer für Spannungsteiler | Würth | 560112132020 | 3 |  | 2
 | Kondensatoren | 10 nF | Glättung der ADC-Pins | Würth | 885012208026 | 3
 | Widerstand | 10 kOhm | Pull-Down für Taster des Joysticks | Würth | 560112132018 | 2 |  | 5
RS485 Transceiver | SP3485-Modul | - | RS485 Transceiver Modul | Max Linear |  | 2 |  | 12
 | Widerstand | 120 Ohm | Abschlusswiderstände für RS485 Leitungen | Würth | 560112140009 | 2 |  | 3
 | Kondensatoren | 100nF | Glättungskondensatoren gegen GND | Würth | 885012208030 | 2
Versorgungsschaltung | Entry Modul | - | Eingangsmodul für Lizen von RS485 Kabel | Würth | 691242510004 | 2
 | LED | Rot | Status LED | Würth | 151051RS11000 | 2
 | Widerstand | 1 kOhm | Vorwiderstand für LED | Würth | 560112132038 | 2 |  | 1
 | Schiebeschalter | - | Auswahlschalter welche Batterie Platine versorgt | Würth | 472123010111 | 1
 | LDO | - | LDO um 5V auf 3.3V runterregeln | TI | TLV1117LV33DCYR | 1 |  | 13
 | Kondesator | 1µF | Kondesator an LDO_in und LDO_out | Würth | 885012208036 | 2
 | Halter | - | Feinsicherungshalter | Würth | 696106003002 | 1
 | Kondensator | 100µF | Pufferkondensator für 5V Schiene | Würth | 870235373001 | 1
 | Kondensator | 10µF | Pufferkondensator für 5V schiene | Würth | 885012208041 | 1 |  | 10
 | Feinsicherung | - | Feinsicherung für Spannungsversorgung | Auf Amazon bestellen |  | 1
Display | Display Modul | - | Display Modul mit I^2C und adapter | Auf Amazon bestellt |  | 1
 | Flachbandkabel | 4 polig | Verbindung platine adapter Display | Würth | 63910415521CAB | 1
 | Stecker-Female | - | Stecker für Flachbandkabel | Würth | 661004152222 | 1
 | Stecker-Male | - | Stecker auf Platine | Würth | 66100411622
