Maxim-1301/Projektarbeit_Joystick/BOM/BOM_Platine.ods

Bauteilgruppe | Bauteile | Charakteristik | Beschreibung | Hersteller | Bauteilnummer | Stückzahl | Bestellstückzahl
STM32F303 | Kondensatoren | 100nF | Nahe an Controller, zwischen Vcc und Gnd | Würth |  | 4
 | Kondensatoren | 4,7 µF | Vor Controller, an 3.3V Schiene, bevor aufteilung an Vcc Pins des Controllers | Würth |  | 1
 | Kondensatoren | 10nF | Zwischen VDDA und VSSA (ADC Versorgungs) | Würth |  | 1
 | Kondensatoren | 1µF | parallel zu 10nF | Würth |  | 1
 | SWD-Buchsenleiste | 5 Pins, belegung bekannt | - | Noch unbekannt | 61300611821 | 1
 | Taster | Höhe= 8mm | ResetTaster | Würth | 430182080816 | 1
 | Widerstand | 10 kOhm | Pull-Down Widerstand für Boot0 Pin | Würth |  | 1
 | Quartz | 16 MHz | Externer Quartz Kristall Oscillator für Taktgebung | Würth | 830058383B | 1
 | Lastkapazitäten | 20pF und 22pF | kondensatoren für OSC_in und OSC_out | Würth |  | 2 und 2
Joysticks | Female DSUB | 15 Pins | Female Stecker für Joystick | Würth | 618015231121 | 1
 | Widerstand R1 | 5,6 kOhm | R1 des Spannungsteilers am Joystick | Würth |  | 3
 | Widerstand R2 | 10 kOhm | R2 des Spannungsteilers am Jystick | Würth |  | 3
 | Widerstand R1.1 | 4,7 kOhm | weniger puffer für Spannungsteiler | Würth |  | 3
