Maxim-1301/Projektarbeit_Joystick/BOM/auftrag_bauteilbeschaffung.xls

Name des Bestellers: |  | Vorlesung | Projekt |  | E-Mail |  | Datum
Maxim Castor und Jonathan Stoll |  | - | Orange-Blue Bootsprojekt |  | maxim.castor@htwg-konstanz.de |  | 2026-06-29
Bauteilbezeichnung |  | Bestellnr. | Lieferant | Link | Anzahl | Einzelpreis | Gesamtpreis
Microcontroller STM32F303RET6 |  | 511-STM32F303RET6 | Mouser Electronics | STM32F303RET6 STMicroelectronics | Mouser Deutschland (https://www.mouser.de/ProductDetail/STMicroelectronics/STM32F303RET6?qs=iEvsikg1EVxqzySz0rz1MQ%3D%3D) | 2 | 9.61 € | 19.22 €
LDO |  | 595-TLV1117LV33DCYR | Mouser Electronics | TLV1117LV33DCYR Texas Instruments | Mouser Deutschland (https://www.mouser.de/ProductDetail/Texas-Instruments/TLV1117LV33DCYR?qs=tEz3BkPb1rwzXMb8FiWhow%3D%3D) | 2 | 0.22 € | 0.45 €
RS485 Transceiver |  | 701-SP3485EN-L | Mouser Electronics | SP3485EN-L MaxLinear | Mouser Deutschland (https://www.mouser.de/ProductDetail/MaxLinear/SP3485EN-L?qs=H%252BP%2FcHWii3c8mP8aY3W2mg%3D%3D) | 4 | 0.83 € | 3.30 €
 |  |  |  |  |  |  | 0.00 €
 |  |  |  |  |  |  | 0.00 €
 |  |  |  |  |  |  | 0.00 €
 |  |  |  |  |  |  | 0.00 €
 |  |  |  |  |  |  | 0.00 €
 |  |  |  |  |  |  | 0.00 €
 |  |  |  |  |  |  | 0.00 €
 |  |  |  |  |  |  | 0.00 €
 |  |  |  |  |  |  | 0.00 €
 |  |  |  |  |  |  | 0.00 €
 |  |  |  |  |  |  | 0.00 €
 |  |  |  |  |  |  | 0.00 €
 |  |  |  |  |  |  | 0.00 €
 |  |  |  |  |  |  | 0.00 €
 |  |  |  |  |  |  | 0.00 €
 |  |  |  |  |  |  | 0.00 €
 |  |  |  |  |  |  | 0.00 €
 |  |  |  |  |  |  | 0.00 €
 |  |  |  |  |  |  | 0.00 €
 |  |  |  |  |  |  | 0.00 €
 |  |  |  |  | Summe: |  | 22.97 €
 | Bei der Auswahl der Bauteile ist auf die Lieferbarkeit zu achten! Aus organisatorischen Gründen werden Artikel, die zum Zeitpunkt der Bestellung nicht lieferbar sind, von der Bestellung ausgenommen. Ersatz muss selbsständig gesucht und mit neuem Formular bestellt werden.
 | Bei der Auswahl der Bauteile ist auf Mindestbestellmengen zu achten! Zur Vermeidung von Kosten und Abfall werden Artikel, bei denen die benötigte Menge kleiner ist als die Mindestbestellmenge, von der Bestellung ausgenommen. Ersatz muss selbstständig gesucht und mit neuem Formular bestellt werden.
