Maxim-1301/Projektarbeit_Joystick/TLV1117LV33DCYR.step

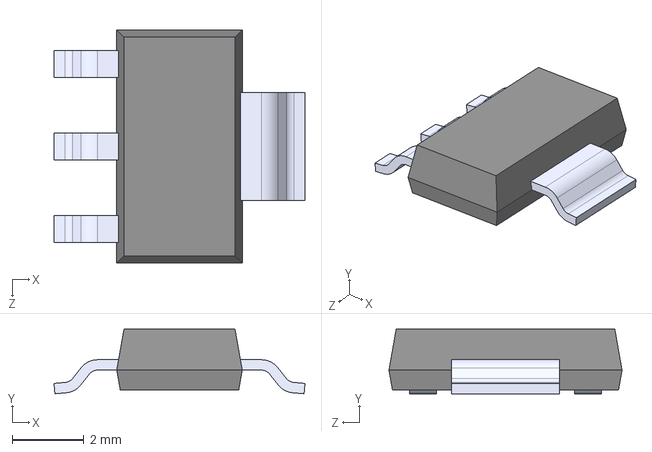
[picture p24: CAD file, 2026-07-14]
TLV1117LV33DCYR.step
7.00 x 1.80 x 6.50 mm
