Maxim-1301/Projektarbeit_Joystick/Software/Software_Joystick_Modul/Software_Joystick_Modul.ioc

Mcu.UserName=STM32F303RETx
PA13.Signal=SYS_JTMS-SWDIO
PA14.Signal=SYS_JTCK-SWCLK
PA6.GPIO_Label=MotorA_DE
PA6.Signal=GPIO_Output
PA7.GPIO_Label=MotorA_NRE
PA7.Signal=GPIO_Output
PB1.GPIO_Label=MotorB_DE
PB1.Signal=GPIO_Output
PB10.GPIO_Label=MotorB_UART_TX
PB10.Signal=USART3_TX
PB11.GPIO_Label=MotorB_UART_RX
PB11.Signal=USART3_RX
PB12.GPIO_Label=Joystick_ADC_X
PB12.Signal=ADC4_IN3
PB13.GPIO_Label=Joystick_Taster1
PB13.Signal=GPIO_Input
PB14.GPIO_Label=Joystick_ADC_Y
PB14.Signal=ADC4_IN4
PB15.GPIO_Label=Joystick_ADC_Z
PB15.Signal=ADC4_IN5
PB2.GPIO_Label=MotorB_NRE
PB2.Signal=GPIO_Output
PB6.Signal=I2C1_SCL
PB7.Signal=I2C1_SDA
PC4.GPIO_Label=MotorA_UART_TX
PC4.Signal=USART1_TX
PC5.GPIO_Label=MotorA_UART_RX
PC5.Signal=USART1_RX
PC6.GPIO_Label=Joystick_Taster2
PC6.Signal=GPIO_Input
PF0-OSC_IN.Signal=RCC_OSC_IN
PF1-OSC_OUT.Signal=RCC_OSC_OUT
