Maxim-1301/Projektarbeit_Joystick/Software/KommModul_RS485_TestApplikation/Core/Src/main.c

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
/* Includes ------------------------------------------------------------------*/
#include "main.h"
#include "usart.h"
#include "gpio.h"

/* USER CODE BEGIN Includes */
#include <stdio.h>
#include "uart_rs485.h"
/* USER CODE END Includes */


void SystemClock_Config(void);
/* USER CODE BEGIN 0 */
int _write(int file, char *ptr, int len)
{
    (void)file;

    for (int i = 0; i < len; i++)
    {
        if (ptr[i] == '\n')
        {
            uint8_t cr = '\r';
            HAL_UART_Transmit(&huart2, &cr, 1, HAL_MAX_DELAY);
        }

        HAL_UART_Transmit(&huart2, (uint8_t *)&ptr[i], 1, HAL_MAX_DELAY);
    }

    return len;
}


/* static void print_rs485_frame(const rs485_frame_t *frame)
{
    printf("%02X %02X %02X %02X %02X  %s",
           frame->data[0],
           frame->data[1],
           frame->data[2],
           frame->data[3],
           frame->data[4],
           frame->checksum_ok ? "OK" : "CRC_ERROR");

    if (frame->error_flags != 0U)
    {
        printf("  USART_ERR=0x%08lX", (unsigned long)frame->error_flags);
    }

    printf("\n");
} */
/* USER CODE END 0 */

/**
  * @brief  The application entry point.
  * @retval int
  */
int main(void)
{

  /* MCU Configuration--------------------------------------------------------*/

  /* Reset of all peripherals, Initializes the Flash interface and the Systick. */
  HAL_Init();

  /* Configure the system clock */
  SystemClock_Config();

  /* Initialize all configured peripherals */
  MX_GPIO_Init();
  MX_USART1_UART_Init();
  MX_USART2_UART_Init();

  /* USER CODE BEGIN 2 */
  uart_rs485_start();

  printf("\nRS485 Sende-/Empfangstest gestartet\n");
  printf("USART1: RS485 TX/RX, 38400 Baud\n");
  printf("USART2: Debug-Ausgabe, 115200 Baud\n\n");
  printf("Alle 30 ms wird ein Telemetrieframe gesendet.\n");
  printf("Reihenfolge: rpm, Leistung, Spannung, Kapazitaet, "
         "Geschwindigkeit, Temperatur\n\n");

  /* Nur für Softwaretest. Später bei echter Messung auskommentieren. */
  //uart_rs485_test_inject_frame();

  rs485_frame_t frame = {0};
  //uint8_t raw_byte = 0;
  //uint8_t raw_count_in_line = 0;
  uint32_t last_diag = 0;
  uint32_t last_printed_tx_count = 0U;
  uint8_t last_tx_frame[RS485_FRAME_LENGTH] = {0U};
  /* USER CODE END 2 */

  /* Infinite loop */
  /* USER CODE BEGIN WHILE */
  while (1)
  {
      /* USER CODE END WHILE */

	  /* USER CODE BEGIN 3 */

	  /*
	   * Bidirektionalen RS485-Test bedienen.
	   * Empfang läuft weiterhin per UART-Interrupt.
	   */
	  uart_rs485_process();

	  /*
	   * Jedes erfolgreich gesendete Frame auf USART2 ausgeben.
	   */
	  if (uart_rs485_get_tx_frame_count() != last_printed_tx_count)
	  {
	      last_printed_tx_count = uart_rs485_get_tx_frame_count();
	      uart_rs485_get_last_tx_frame(last_tx_frame);

	      printf("%lu ms TX:    %02X %02X %02X %02X %02X\n",
	             (unsigned long)HAL_GetTick(),
	             last_tx_frame[0],
	             last_tx_frame[1],
	             last_tx_frame[2],
	             last_tx_frame[3],
	             last_tx_frame[4]);
	  }

	  /*
	   * Rohbytes ausgeben.
	   * Für sehr lange Messungen kann man das später deaktivieren,
	   * aber für die aktuelle Fehlersuche ist es hilfreich.
	   */
	/*  while (uart_rs485_get_raw_byte(&raw_byte))
	  {
	      printf("%02X ", raw_byte);

	      raw_count_in_line++;

	      if (raw_count_in_line >= 16U)
	      {
	          raw_count_in_line = 0;
	          printf("\n");
	      }
	  }*/

	  /*
	   * Erkannte Frames zusätzlich ausgeben.
	   * Falls die Ausgabe zu viel wird, kannst du diesen Block testweise auskommentieren.
	   */
	  while (uart_rs485_get_frame(&frame))
	  {
	      printf("%lu ms FRAME: %02X %02X %02X %02X %02X  %s\n",
	             (unsigned long)HAL_GetTick(),
	             frame.data[0],
	             frame.data[1],
	             frame.data[2],
	             frame.data[3],
	             frame.data[4],
	             frame.checksum_ok ? "OK" : "CRC_ERROR");
	  }
	  /*
	   * Diagnose einmal pro Sekunde.
	   */
	  if (HAL_GetTick() - last_diag >= 1000U)
	  {
	      last_diag = HAL_GetTick();

	      printf("\n%lu ms DIAG rx=%lu tx=%lu tx_err=%lu "
	             "last_tx_cmd=%02X last_tx_value=%u "
	             "last_rx=%02X raw_lost=%lu frame_lost=%lu "
	             "uart_err=%lu last_err=0x%08lX ISR=0x%08lX "
	             "FE=%lu NE=%lu ORE=%lu PE=%lu\n",
	             (unsigned long)HAL_GetTick(),
	             (unsigned long)uart_rs485_get_rx_byte_count(),
	             (unsigned long)uart_rs485_get_tx_frame_count(),
	             (unsigned long)uart_rs485_get_tx_error_count(),
	             uart_rs485_get_last_tx_command(),
	             (unsigned int)uart_rs485_get_last_tx_value(),
	             uart_rs485_get_last_rx_byte(),
	             (unsigned long)uart_rs485_get_raw_lost_count(),
	             (unsigned long)uart_rs485_get_lost_frame_count(),
	             (unsigned long)uart_rs485_get_error_count(),
	             (unsigned long)uart_rs485_get_last_uart_error(),
	             (unsigned long)uart_rs485_get_last_usart_isr(),
	             (unsigned long)uart_rs485_get_framing_error_count(),
	             (unsigned long)uart_rs485_get_noise_error_count(),
	             (unsigned long)uart_rs485_get_overrun_error_count(),
	             (unsigned long)uart_rs485_get_parity_error_count());
	  }
      /* USER CODE END 3 */
  }
  /* USER CODE END 3 */
}

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
