Maxim-1301/Projektarbeit_Joystick/(commit log)

2026-07-14 Commit vor PCB Layout
    [.kicad_sch, KomModul_TragFluegel.kicad_sch, Pinlayout_Microcontroller.xlsx]
2026-07-14 Commit new PCB Layout
    [.kicad_sch, KomModul_TragFluegel.kicad_pcb, KommModul_Joystick.kicad_pcb, KommModul_Joystick.kicad_sch, TLV1117LV33DCYR.step, aisler-2-layer-simple-drc.kicad_pcb, aisler-2-layer-simple-drc.kicad_sch]
2026-07-14 Manyak Maxim
    Whääää
    [KommModul_Joystick.kicad_sch]
2026-07-14 cleaning branch
    Löschen unwichtiger files
    [.kicad_sch, BOM_Platine.ods, BOM_Platine.ods.xlsx, BOM_Platine.xlsx, BOM_Wuerth.xlsx, KomModul_TragFluegel.kicad_pcb, KomModul_TragFluegel.kicad_sch, KomModul_TragFluegel.sch]
2026-07-14 Libraries included to Project Path
    [Git_WE_KiCad_Released_Series_List.xlsx]
2026-07-15 Footprint LDO Change
2026-07-15 PCB Routing V1
    [KommModul_Joystick.kicad_pcb]
2026-07-15 change pcb v2
    [BOM_Platine.xlsx, KommModul_Joystick.kicad_pcb]
2026-07-15 update schaltplan
    [KommModul_Joystick.kicad_sch]
2026-07-15 PCB Layout V2
    [KommModul_Joystick.kicad_pcb, KommModul_Joystick.kicad_sch]
2026-07-15 Update PCB mit GND Plane
    [KommModul_Joystick.kicad_pcb, KommModul_Joystick.kicad_sch]
2026-07-16 PCB Layout Change
    Ueberarbeitung des Routing, hinzufuegen von GND Zonen
    Bohrungen fehlen noch
    [KommModul_Joystick.kicad_pcb]
2026-07-17 Final Changes
    Finale Aenderung am PCB Erzeugung der Drill und Gerber Files
    [KommModul_Joystick.kicad_pcb, KommModul_Joystick.kicad_sch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]
2026-07-17 gerber Files
    [KommModul_Joystick-B_Cu.gbr, KommModul_Joystick-B_Mask.gbr, KommModul_Joystick-B_Paste.gbr, KommModul_Joystick-B_Silkscreen.gbr, KommModul_Joystick-Edge_Cuts.gbr, KommModul_Joystick-F_Cu.gbr, KommModul_Joystick-F_Mask.gbr, KommModul_Joystick-F_Paste.gbr]
2026-07-18 Small Changes on Markings etc.
    [KommModul_Joystick.kicad_pcb]
2026-07-18 Gerber Files new
    [KommModul_Joystick-B_Cu.gbr, KommModul_Joystick-B_Mask.gbr, KommModul_Joystick-B_Paste.gbr, KommModul_Joystick-B_Silkscreen.gbr, KommModul_Joystick-Edge_Cuts.gbr, KommModul_Joystick-F_Cu.gbr, KommModul_Joystick-F_Mask.gbr, KommModul_Joystick-F_Paste.gbr]
2026-07-18 J2 to the edge of PCB
    [KommModul_Joystick-B_Cu.gbr, KommModul_Joystick-B_Mask.gbr, KommModul_Joystick-B_Paste.gbr, KommModul_Joystick-B_Silkscreen.gbr, KommModul_Joystick-Edge_Cuts.gbr, KommModul_Joystick-F_Cu.gbr, KommModul_Joystick-F_Mask.gbr, KommModul_Joystick-F_Paste.gbr]
2026-07-21 Software Module
    [KommModul_Joystick.kicad_pcb]
2026-07-28 BOM changes for soldering
    [BOM_Platine.xlsx]
2026-07-28 Test Applikation Umbau auf Senden und Empfangen
2026-08-28 Finale Bearbeitung der Doku
