Maxim-1301/Projektarbeit_Joystick/(notices)

Notices in the files:
Software/KommModul_RS485_TestApplikation/Core/Src/main.c:
Copyright (c) 2026 STMicroelectronics.
All rights reserved.
This software is licensed under terms that can be found in the LICENSE file
